anand2532/Nomiq/hardware/datasheets/README.md

# Datasheets & reference designs (links — don't commit PDFs)

| Part | Documents |
|---|---|
| ESP32-S3-WROOM-1 | Datasheet; ESP32-S3 Hardware Design Guidelines (Espressif) |
| SX1262 | Datasheet DS.SX1261-2; reference design 868 MHz (Semtech); AN1200.13 LoRa modem designer's guide |
| OV2640 | Datasheet; esp32-camera driver (github.com/espressif/esp32-camera) |
| ICS-43434 | Datasheet (TDK InvenSense) |
| MAX98357A | Datasheet (Analog Devices) |
| BQ25895 / BQ24074 | Datasheets (TI) |
| MAX17048 | Datasheet (Analog Devices) |
| TPS63001 | Datasheet (TI SLVS520) — DRC package, fixed 3.3 V |
| TPS22918, TLV755P | Datasheets (TI) |
| PE4259 | Datasheet (pSemi) |
| TG2016SMN | Datasheet (Epson) |
| TCA9535 | Datasheet (TI) |
