anand2532/Nomiq/docs/specs/ui-and-storage.md

# UI Flows & Local Storage

## 1. Controls

| Control | Short press | Long press |
|---|---|---|
| UP / DOWN | Move selection | Page scroll |
| SELECT | Confirm | Context menu |
| BACK | Back | Home |
| RECORD (side) | — | Hold-to-record (PTT) |
| CAMERA (side) | Open camera / capture | — |
| POWER | Screen on/off | 3 s: power off (ship mode) |

## 2. Screen map

```mermaid
stateDiagram-v2
  [*] --> Home
  Home --> Contacts: SELECT recipient
  Contacts --> Compose
  Compose --> VoiceRec: hold RECORD
  VoiceRec --> VoicePreview: release
  VoicePreview --> Sending: SEND
  Compose --> STT: "Voice to text"
  STT --> TextPreview: FINAL
  TextPreview --> Editor: EDIT
  TextPreview --> Sending: SEND
  Compose --> Camera: CAMERA
  Camera --> PhotoPreview: capture
  PhotoPreview --> Camera: RETAKE
  PhotoPreview --> Sending: SEND (shows size + ETA)
  Sending --> Home: delivered / backgrounded
  Home --> Inbox
  Inbox --> Viewer: open text / play voice / view photo
  Home --> Settings: radio, codec, photo quality, language, pairing
```

Implementation: `firmware/components/ui/ui_model.c` — a pure state machine (events in → view state + actions out) that the LVGL renderer draws. `test_ui_model.c` drives Modes 1–4 end to end (84 checks), incl. max recording length, low-confidence STT → send as voice, photo size/ETA, cancel, wake-on-receive, PTT from a dark screen and pairing.

Status bar on every screen: own ID, selected peer, RSSI/SNR bars, battery %, charging icon, active-transfer mini-progress.

**Long-transfer UX (REQ-UI-004):** before sending voice/photo show "≈ 1 min 15 s at current signal". During: % complete, ETA, retries, "Pause / Cancel / Run in background". Duty-cycle profile waits are shown as "Waiting for radio quota — 3 min".

## 3. Storage layout (microSD, FAT32)

```
/sd/nomiq/
  index.log            append-only log of 64-byte CRC-protected records (PUT / STATE)
  out/<peer>/<seq>.{txt,c2,jpg}
  in/<peer>/<seq>.{txt,c2,jpg}
  partial/<name>.bin   resumable receive state, written atomically (tmp + rename)
  pcm/tmp.pcm          raw recording scratch (deleted after encode/STT)
  contacts.json        paired peers: id, name, pubkey fingerprint
```

Keys are **not** on SD — they live in encrypted NVS.

**Storage-full (REQ-STO-004):** below 5 % free → warn; below 1 % → REJECT incoming bulk objects (reason STORAGE_FULL), still accept text; offer "delete oldest media".
Implementation: `firmware/components/storage/msg_store.c` (host-tested: `make test-storage`). A torn tail record after power loss is detected by CRC and truncated; the log is compacted when it exceeds 4× the live records. RAM index holds the newest 1024 messages.

**Persistence (REQ-STO-003):** every state change appended to `index.log` with fsync before radio action; on boot, PENDING/SENDING → PENDING and resume.
