anand2532/Nomiq/docs/specs/communication-protocol.md

# Nomiq Air Protocol — v1 (draft)

Reference implementation: `firmware/components/nomiq_proto/` (host-testable C). This document is normative; if code and doc disagree, open an issue.

## 1. Frame format

Max LoRa PHY payload 255 B. All multi-byte fields **little-endian**.

```
plaintext :  | header (20) | payload (len)                         |
encrypted :  | header (20) | ctr (4) | ciphertext (len) | MIC (8)  |   flags.b4 = 1
```

Header:

```
 0      1      2      3      4          8          12       14       16       18       20
+------+------+------+------+----------+----------+--------+--------+--------+--------+
| ver  | type | flags| len  | src u32  | dst u32  | msg_id | frag_ix| frag_n | crc16  |
+------+------+------+------+----------+----------+--------+--------+--------+--------+
```

| Field | Size | Description |
|---|---|---|
| `ver` | 1 | Protocol version = `1` |
| `type` | 1 | See §2 |
| `flags` | 1 | b0-1 priority (0 = control … 3 = photo), b2 ACK requested, b3 retransmission, b4 encrypted, b5-7 reserved |
| `len` | 1 | Plaintext payload length, 0–223 |
| `src` / `dst` | 4 / 4 | Device IDs. `0xFFFFFFFF` = broadcast (BEACON only) |
| `msg_id` | 2 | Per-sender message counter |
| `frag_ix` | 2 | Fragment index (0-based). For SACK = window base |
| `frag_n` | 2 | Total fragments of the object; 1 for single-frame messages |
| `crc16` | 2 | CRC-16/CCITT-FALSE over header bytes 0–17 **and every byte after the header** (payload, or ctr+ciphertext+MIC). Cheap corruption filter before crypto |
| `ctr` | 4 | Sender's 32-bit frame counter (encrypted frames) — nonce input and replay protection |
| `MIC` | 8 | AES-128-CCM tag |

Header = **20 B**, security trailer = **12 B**, max payload per fragment = 255 − 20 − 12 = **223 B**.

## 2. Message types

| Code | Name | Direction | Payload |
|---|---|---|---|
| 0x01 | TEXT | A→B | UTF-8 text ≤ 223 B (longer text is sent as an object) |
| 0x02 | OFFER | A→B | `obj_type u8` (text/voice/photo), `size u32`, `sha256[0:8]`, `codec/format u8`, `meta…` |
| 0x03 | ACCEPT | B→A | resume bitmap (fragments already held), optional data-channel |
| 0x04 | DATA | A→B | fragment bytes |
| 0x05 | SACK | B→A | 64-bit bitmap of window starting at `frag_ix`, `snr i8`, `rssi i8` |
| 0x06 | DONE | B→A | object verified & stored |
| 0x07 | CANCEL | either | reason u8 |
| 0x08 | REJECT | B→A | reason: storage full / too big / unknown sender |
| 0x09 | BEACON | broadcast | name, battery, capabilities (discovery) |
| 0x0A | PAIR | A↔B | X25519 public key + nonce (pairing) |
| 0x0B | ACK | B→A | ACK for TEXT / control frames |

## 3. Reliability

* **ACK/retry:** frames that expect a reply (TEXT, OFFER, last DATA of a window, probes) carry `ACK_REQ`. Timeout = 2ⁿ × (2·ToA + 300 ms) + jitter (n capped at 6), max **8** retries before `FAILED` (the message stays resumable).
* **Half-duplex listen hold:** after a frame with `ACK_REQ` the sender keeps the radio in RX for ≈ 2·ToA + 100 ms (or until the reply), so replies are never lost to our own transmissions.
* **Timeout recovery:** first timeout → probe (re-send the first unacknowledged fragment with `ACK_REQ`); further timeouts → re-OFFER. Re-OFFER also recovers a receiver that rebooted: it reloads the persisted partial by `(src, sha8)` and answers ACCEPT with its bitmap.
* **Windowed selective-repeat:** sender transmits up to 16 DATA frames (inside the 64-fragment SACK span), the last with `ACK_REQ`, then waits for SACK. Only missing fragments are resent. ACCEPT and SACK bitmaps are **authoritative** snapshots of the receiver (a receiver that discarded a corrupt object can un-acknowledge fragments).
* **Duplicate filter:** receiver keeps an LRU of the last 64 `(src, msg_id, frag_ix, type)` tuples; duplicates are re-ACKed but not re-processed.
* **Integrity:** per-frame CRC16 + MIC; per-object truncated SHA-256 in OFFER checked after reassembly. Mismatch → discard and request full resend.
* **Timeouts:** receiver drops an incomplete object after 30 min idle (configurable) but **keeps fragments on SD** so the sender can resume.
* **Resume:** both sides persist the bitmap on SD. A new OFFER with the same `(src, sha)` gets an ACCEPT carrying the bitmap of fragments already held.
* **Priority:** the scheduler (`nomiq_sched_pick`) grants the air one frame at a time: control > text > voice > photo. A text queued during a photo goes out after the current fragment (simulated: 0.6 s), not after the window.
* **Duty cycle:** `nomiq_duty_*` keeps a rolling 1-hour airtime ledger (60 × 1-min buckets) for the `IN865_SRD2021` profile; the radio layer checks `can_send` before every frame.

Reference implementation and tests: `nomiq_xfer.[ch]`, `test/test_nomiq_xfer.c` — discrete-event simulation with loss, half-duplex collisions, receiver/sender reboot, corruption, storage-full and a 60-run Monte-Carlo at 25 % loss.

## 4. Security

Implementation: `nomiq_crypto.[ch]` (+ `crypto_mbedtls.c` on ESP-IDF, `crypto_openssl.c` for host tests). Verified against RFC 3610 (CCM), RFC 5869 (HKDF) and RFC 7748 (X25519) vectors in `test/test_nomiq_crypto.c`.

* **Pairing (TOFU + confirmation):** devices exchange X25519 public keys in PAIR frames; both screens show a 6-digit code `HKDF(shared, "code" ‖ min(id) ‖ max(id)) mod 10⁶`; both users confirm. Keys stored in encrypted NVS.
* **Link key:** `K = HKDF-SHA256(salt = "nomiq v1", IKM = X25519 shared, info = "key " ‖ min(id) ‖ max(id))[0:16]`.
* **Cipher:** AES-128-CCM, 8-byte tag, AAD = header bytes 0–17 (so `dst`, `type`, `msg_id`, `frag_*`, `flags`, `len` are authenticated).
* **Nonce (13 B):** `src(4) ‖ ctr(4) ‖ type(1) ‖ msg_id(2) ‖ frag_ix(2)`. `ctr` is a per-sender frame counter that increments for **every** transmitted frame (including retransmissions), so a nonce is never reused under one key. The counter is persisted in NVS in blocks of 1024: on boot the device skips to the next block boundary.
* **Replay protection:** receiver keeps a 64-frame sliding window per peer (`nomiq_replay_accept`). The window is RAM-only; after a receiver reboot the first frame re-anchors it (accepted risk, documented).
* **Ordering on RX:** CRC → MIC/decrypt → replay window → protocol engine. Failures are counted in link statistics, never answered.
* Unpaired senders → REJECT (configurable "open mode" for demos). BEACON is plaintext.

## 5. State machines

Sender: `PENDING → OFFERED → SENDING(window) ↔ WAIT_SACK → WAIT_DONE → DELIVERED` (+ `FAILED`, `CANCELLED`, `PAUSED` for duty-cycle wait or user pause).
Receiver: `IDLE → RECEIVING → VERIFY → STORED`, `PARTIAL` (persisted, resumable).

## 6. Versioning

Unknown `ver` → drop silently. New optional fields go in payload TLVs; header layout is frozen for v1.
