anand2532/Nomiq/hardware/bom/bom-summary.md

# Nomiq A0 — cost summary (generated by hardware/design/gen_bom.py)

USD, list prices on 2026-10-24 where sourced, otherwise estimates — re-quote before ordering.

| Block | qty 1 (prototype) | qty 100 |
|---|---:|---:|
| Board components (125 placed parts, 71 lines) | 40.66 | 27.80 |
| PCB + assembly | 22.00 | 4.70 |
| Off-board (battery, speaker, camera, antenna, SD, enclosure, screws) | 20.80 | 13.80 |
| **Device total (without STT SoM)** | **83.46** | **46.30** |
| STT co-processor SoM (Phase 3, ADR-0002) | +15.00 | +12.00 |

## Largest line items (qty 1)

| Item | refs | ext. USD |
|---|---|---:|
| 2.4in 240x320 ILI9341 SPI module, 1x14 2.54 mm | J7 | 5.00 |
| TDK InvenSense ICS-43434 | U5 | 4.62 |
| Espressif ESP32-S3-WROOM-1-N16R8 | U1 | 4.60 |
| Semtech SX1262IMLTRT | U2 | 3.22 |
| Epson TG2016SMN 32.0000M-ECGNNM3 | Y1 | 2.79 |
| TI BQ24074RGTR | U8 | 2.53 |
| Molex 104031-0811 | J8 | 2.30 |
| Analog Devices MAX17048G+T10 | U9 | 2.11 |

## Supply risks

- **TI BQ24074RGTR** (U8): LCSC out of stock on 2026-10-24 - buy from TI/DigiKey or pre-order
- **Epson TG2016SMN 32.0000M-ECGNNM3** (Y1): 0 stock, 20 wk lead - order early or use a JLC-stocked 32 MHz 1.8 V TG2016 variant
