anand2532/Nomiq/hardware/bom/bom-costed.csv

designators | qty | mpn | value | footprint | lcsc | unit_usd_q1 | unit_usd_q100 | ext_usd_q1 | ext_usd_q100 | price_source | availability
J1 | 1 | GCT USB4105-GF-A | USB-C 16P | USB_C_Receptacle_GCT_USB4105-xx-A_16P_TopMnt_Horizontal |  | 0.800 | 0.550 | 0.80 | 0.55 | est.
R1 R2 | 2 |  | 5.1k | R_0402_1005Metric |  | 0.002 | 0.001 | 0.00 | 0.00 | est. (JLC basic part)
D1 | 1 | STMicro USBLC6-2SC6 | USBLC6-2SC6 | SOT-23-6 | C7519 | 0.120 | 0.070 | 0.12 | 0.07 | est.
D2 | 1 | Littelfuse SMF5.0A | SMF5.0A | D_SOD-123F |  | 0.100 | 0.050 | 0.10 | 0.05 | est.
C1 C6 C41 | 3 |  | 10uF/10V | C_0603_1608Metric |  | 0.010 | 0.005 | 0.03 | 0.01 | est. (JLC basic part)
U8 | 1 | TI BQ24074RGTR | BQ24074 | VQFN-16-1EP_3x3mm_P0.5mm_EP1.6x1.6mm | C54313 | 2.530 | 1.780 | 2.53 | 1.78 | LCSC | LCSC out of stock on 2026-10-24 - buy from TI/DigiKey or pre-order
R3 | 1 |  | 887R 1% | R_0402_1005Metric |  | 0.002 | 0.001 | 0.00 | 0.00 | est. (JLC basic part)
R4 | 1 |  | 1.13k 1% | R_0402_1005Metric |  | 0.002 | 0.001 | 0.00 | 0.00 | est. (JLC basic part)
R5 | 1 |  | 2.94k 1% | R_0402_1005Metric |  | 0.002 | 0.001 | 0.00 | 0.00 | est. (JLC basic part)
R6 | 1 |  | 37.4k 1% | R_0402_1005Metric |  | 0.002 | 0.001 | 0.00 | 0.00 | est. (JLC basic part)
R7 R8 R9 R13 R40 R41 R43 R50 R61 | 9 |  | 100k | R_0402_1005Metric |  | 0.002 | 0.001 | 0.02 | 0.01 | est. (JLC basic part)
C2 C5 C10 | 3 |  | 1uF/10V | C_0402_1005Metric |  | 0.003 | 0.002 | 0.01 | 0.00 | est. (JLC basic part)
C3 C4 | 2 |  | 4.7uF/10V | C_0603_1608Metric |  | 0.010 | 0.005 | 0.02 | 0.01 | est. (JLC basic part)
J2 | 1 | JST S3B-PH-SM4-TB | Battery JST-PH 3P (+, NTC, -) | JST_PH_S3B-PH-SM4-TB_1x03-1MP_P2.00mm_Horizontal |  | 0.200 | 0.120 | 0.20 | 0.12 | est.
U9 | 1 | Analog Devices MAX17048G+T10 | MAX17048 | TDFN-8-1EP_2x2mm_P0.5mm_EP0.8x1.2mm | C2682616 | 2.110 | 1.510 | 2.11 | 1.51 | LCSC | 25k in stock
U10 | 1 | TI TPS63001DRCR | TPS63001 | Texas_S-PVSON-N10 | C28060 | 1.620 | 1.010 | 1.62 | 1.01 | LCSC | 10k in stock
L1 | 1 | Taiyo Yuden NRS4018T2R2MDGJ | 2.2uH | L_Taiyo-Yuden_NR-40xx |  | 0.150 | 0.080 | 0.15 | 0.08 | est.
C7 C8 C21 | 3 |  | 22uF/6.3V | C_0805_2012Metric |  | 0.030 | 0.015 | 0.09 | 0.04 | est. (JLC basic part)
U14 | 1 | TI TPS22918DBVR | TPS22918 (STT rail) | SOT-23-6 |  | 0.350 | 0.200 | 0.35 | 0.20 | est.
C9 C50 | 2 |  | 1nF | C_0402_1005Metric |  | 0.003 | 0.002 | 0.01 | 0.00 | est. (JLC basic part)
C11 | 1 |  | 22uF/10V | C_0805_2012Metric |  | 0.030 | 0.015 | 0.03 | 0.01 | est. (JLC basic part)
U1 | 1 | Espressif ESP32-S3-WROOM-1-N16R8 | ESP32-S3-WROOM-1-N16R8 | ESP32-S3-WROOM-1 | C2913202 | 4.600 | 3.900 | 4.60 | 3.90 | est. (JLC extended part C2913202)
R20 R21 R30 R66 R62 R63 | 6 |  | 10k | R_0402_1005Metric |  | 0.002 | 0.001 | 0.01 | 0.01 | est. (JLC basic part)
C20 C51 C52 C53 | 4 |  | 1uF | C_0402_1005Metric |  | 0.003 | 0.002 | 0.01 | 0.01 | est. (JLC basic part)
C22 C23 C32 C35 C40 C42 C62 | 7 |  | 0.1uF | C_0402_1005Metric |  | 0.003 | 0.002 | 0.02 | 0.01 | est. (JLC basic part)
SW1 | 1 | C&K PTS810 SJM 250 SMTR LFS | RESET | SW_SPST_PTS810 |  | 0.180 | 0.110 | 0.18 | 0.11 | est.
SW2 | 1 | C&K PTS810 SJM 250 SMTR LFS | BOOT | SW_SPST_PTS810 |  | 0.180 | 0.110 | 0.18 | 0.11 | est.
R22 R23 | 2 |  | 0R | R_0402_1005Metric |  | 0.002 | 0.001 | 0.00 | 0.00 | est. (JLC basic part)
J3 | 1 | Tag-Connect TC2030-IDC-NL | TC2030-IDC-NL | Tag-Connect_TC2030-IDC-NL_2x03_P1.27mm_Vertical |  | 0.000 | 0.000 | 0.00 | 0.00 | footprint only (cable reused) | no part placed
U4 | 1 | TI TCA9535PWR | TCA9535 | TSSOP-24_4.4x7.8mm_P0.65mm | C130204 | 1.340 | 0.920 | 1.34 | 0.92 | LCSC | 7k in stock
R24 R25 | 2 |  | 2.2k | R_0402_1005Metric |  | 0.002 | 0.001 | 0.00 | 0.00 | est. (JLC basic part)
U2 | 1 | Semtech SX1262IMLTRT | SX1262 | QFN-24-1EP_4x4mm_P0.5mm_EP2.6x2.6mm | C191341 | 3.220 | 1.890 | 3.22 | 1.89 | LCSC | 1.5k-31k in stock
L2 | 1 | Murata LQM21FN150M70L | 15uH | L_0805_2012Metric |  | 0.060 | 0.030 | 0.06 | 0.03 | est.
C30 | 1 |  | 470nF | C_0402_1005Metric |  | 0.003 | 0.002 | 0.00 | 0.00 | est. (JLC basic part)
C31 | 1 |  | 47nF | C_0402_1005Metric |  | 0.003 | 0.002 | 0.00 | 0.00 | est. (JLC basic part)
C33 C60 C61 | 3 |  | 10uF/6.3V | C_0603_1608Metric |  | 0.010 | 0.005 | 0.03 | 0.01 | est. (JLC basic part)
Y1 | 1 | Epson TG2016SMN 32.0000M-ECGNNM3 | TCXO 32 MHz 1.8 V ±2 ppm | Crystal_SMD_2016-4Pin_2.0x1.6mm |  | 2.790 | 2.790 | 2.79 | 2.79 | Future Electronics (MOQ 250) | 0 stock, 20 wk lead - order early or use a JLC-stocked 32 MHz 1.8 V TG2016 variant
R31 | 1 |  | 220R | R_0402_1005Metric |  | 0.002 | 0.001 | 0.00 | 0.00 | est. (JLC basic part)
C34 | 1 |  | 10pF | C_0402_1005Metric |  | 0.003 | 0.002 | 0.00 | 0.00 | est. (JLC basic part)
U3 | 1 | pSemi PE4259-63 | PE4259 | SOT-363_SC-70-6 | C470892 | 0.950 | 0.600 | 0.95 | 0.60 | est. (LCSC C470892)
L3 | 1 | Murata LQW15AN47NJ00 | 47nH | L_0402_1005Metric |  | 0.050 | 0.020 | 0.05 | 0.02 | est.
C36 | 1 |  | 4.7pF | C_0402_1005Metric |  | 0.003 | 0.002 | 0.00 | 0.00 | est. (JLC basic part)
L4 L5 | 2 | Murata LQW15AN12NJ00 | 12nH | L_0402_1005Metric |  | 0.050 | 0.020 | 0.10 | 0.04 | est.
C37 | 1 |  | 6.8pF | C_0402_1005Metric |  | 0.003 | 0.002 | 0.00 | 0.00 | est. (JLC basic part)
C38 | 1 |  | 3.3pF | C_0402_1005Metric |  | 0.003 | 0.002 | 0.00 | 0.00 | est. (JLC basic part)
C39 C43 | 2 |  | 47pF | C_0402_1005Metric |  | 0.003 | 0.002 | 0.01 | 0.00 | est. (JLC basic part)
C44 C45 | 2 |  | 2.7pF | C_0402_1005Metric |  | 0.003 | 0.002 | 0.01 | 0.00 | est. (JLC basic part)
L6 L7 | 2 | Murata LQW15AN27NJ00 | 27nH | L_0402_1005Metric |  | 0.050 | 0.020 | 0.10 | 0.04 | est.
C47 | 1 |  | 100pF | C_0402_1005Metric |  | 0.003 | 0.002 | 0.00 | 0.00 | est. (JLC basic part)
J4 | 1 | Hirose U.FL-R-SMT-1(10) | u.FL | U.FL_Hirose_U.FL-R-SMT-1_Vertical |  | 0.250 | 0.150 | 0.25 | 0.15 | est.
D3 | 1 | Infineon ESD0P2RF-02LS | ESD RF (low C) | D_0201_0603Metric |  | 0.120 | 0.060 | 0.12 | 0.06 | est.
U5 | 1 | TDK InvenSense ICS-43434 | ICS-43434 | InvenSense_ICS-43434-6_3.5x2.65mm | C5656610 | 4.620 | 2.200 | 4.62 | 2.20 | LCSC qty 1; qty-100 est. | 1.6k in stock
U6 | 1 | Analog Devices MAX98357AETE+T | MAX98357A | TQFN-16-1EP_3x3mm_P0.5mm_EP1.23x1.23mm | C910544 | 1.330 | 0.950 | 1.33 | 0.95 | LCSC (qty-100 est.) | 22k in stock
J5 | 1 | JST SM02B-SRSS-TB | Speaker JST-SH 2P | JST_SH_SM02B-SRSS-TB_1x02-1MP_P1.00mm_Horizontal |  | 0.120 | 0.070 | 0.12 | 0.07 | est.
J6 | 1 | Hirose FH12-24S-0.5SH(55) | OV2640 24P FPC 0.5 mm | Hirose_FH12-24S-0.5SH_1x24-1MP_P0.50mm_Horizontal |  | 0.750 | 0.450 | 0.75 | 0.45 | est.
U12 | 1 | TI TLV75528PDBVR | TLV75528 (2.8 V) | SOT-23-5 |  | 0.150 | 0.080 | 0.15 | 0.08 | est.
U13 | 1 | TI TLV75512PDBVR | TLV75512 (1.2 V) | SOT-23-5 |  | 0.150 | 0.080 | 0.15 | 0.08 | est.
U15 | 1 | TI TPS22918DBVR | TPS22918 (cam 3V3) | SOT-23-6 |  | 0.350 | 0.200 | 0.35 | 0.20 | est.
R51 | 1 |  | 33R | R_0402_1005Metric |  | 0.002 | 0.001 | 0.00 | 0.00 | est. (JLC basic part)
J7 | 1 | 2.4in 240x320 ILI9341 SPI module, 1x14 2.54 mm | TFT 2.4in ILI9341 SPI module (14-pin) | TFT_2.4in_ILI9341_1x14 |  | 5.000 | 3.500 | 5.00 | 3.50 | est. (India retail ~INR 400-450) | touch variant OK, touch unused
Q2 | 1 | Nexperia 2N7002,215 | 2N7002 | SOT-23 | C8545 | 0.020 | 0.010 | 0.02 | 0.01 | est.
Q1 | 1 | AOS AO3401A | AO3401A | SOT-23 | C15127 | 0.030 | 0.020 | 0.03 | 0.02 | est.
R60 | 1 |  | 4.7R | R_0402_1005Metric |  | 0.002 | 0.001 | 0.00 | 0.00 | est. (JLC basic part)
J8 | 1 | Molex 104031-0811 | microSD push-push | microSD_HC_Molex_104031-0811 |  | 2.300 | 1.750 | 2.30 | 1.75 | element14 (AUD 3.55 -> USD) | 15k in stock
R64 R65 R70 R71 R72 R73 R74 R75 | 8 |  | 47k | R_0402_1005Metric |  | 0.002 | 0.001 | 0.02 | 0.01 | est. (JLC basic part)
SW3 SW4 SW5 SW6 | 4 | C&K PTS810 SJM 250 SMTR LFS | button (front) | SW_SPST_PTS810 |  | 0.180 | 0.110 | 0.72 | 0.44 | est.
D70 D71 D72 D73 D74 D75 | 6 | Nexperia PESD5V0S1BL | ESD | D_SOD-882 |  | 0.050 | 0.030 | 0.30 | 0.18 | est.
SW7 | 1 | Panasonic EVQ-P7A01P | button (left side) | SW_SPST_EVQP7A |  | 0.350 | 0.220 | 0.35 | 0.22 | est.
SW8 | 1 | Panasonic EVQ-P7A01P | button (right side) | SW_SPST_EVQP7A |  | 0.350 | 0.220 | 0.35 | 0.22 | est.
SW9 | 1 | Panasonic EVQ-P7A01P | POWER (ship-mode / wake) | SW_SPST_EVQP7A |  | 0.350 | 0.220 | 0.35 | 0.22 | est.
J9 | 1 | Samtec FTSH-105-01-L-DV | STT SoM interface 2x5 1.27 mm | PinHeader_2x05_P1.27mm_Vertical_SMD |  | 1.500 | 1.000 | 1.50 | 1.00 | est. | only if the STT SoM is fitted
(off-board) | 1 | 1S Li-ion pouch 3000 mAh (50x80x8 mm) with PCM + 10k NTC, JST-PH 3P |  |  |  | 6.00 | 4.00 | 6.00 | 4.00 | est.
(off-board) | 1 | Speaker 28 mm 8 ohm 1 W with JST-SH 2P lead |  |  |  | 0.90 | 0.50 | 0.90 | 0.50 | est.
(off-board) | 1 | OV2640 camera module, 24-pin 0.5 mm flex, 66-120 deg lens |  |  |  | 4.00 | 2.80 | 4.00 | 2.80 | est. (India retail)
(off-board) | 1 | 868 MHz antenna (SMA, 2-3 dBi) + u.FL-to-SMA bulkhead pigtail 100 mm |  |  |  | 3.00 | 1.80 | 3.00 | 1.80 | est.
(off-board) | 1 | microSD card 16 GB |  |  |  | 3.50 | 2.50 | 3.50 | 2.50 | est.
(off-board) | 1 | Enclosure FDM print (PETG/ASA, ~70 g) + 4 button caps |  |  |  | 3.00 | 2.00 | 3.00 | 2.00 | est. (material only)
(off-board) | 1 | M2.5x16 screws x4 + M2.5 heat-set inserts x4 |  |  |  | 0.40 | 0.20 | 0.40 | 0.20 | est.
(off-board) | 0 | STT co-processor SoM (ADR-0002, Phase 3) |  |  |  | 15.00 | 12.00 | 0.00 | 0.00 | est. - not in A0 build
(fab) | 1 | PCB 4-layer 1.6 mm ENIG 64.6x124.6 mm (per board, qty 5 / qty 100) |  |  |  | 8.00 | 2.20 | 8.00 | 2.20 | est. (JLCPCB)
(fab) | 1 | SMT assembly both sides (setup amortised over 5 / 100) + extended-part fees |  |  |  | 14.00 | 2.50 | 14.00 | 2.50 | est. (JLCPCB)
