anand2532/Nomiq/hardware/kicad/nomiq/nomiq.kicad_pcb

## KiCad design hardware/kicad/nomiq/nomiq.kicad_pcb (2026-10-24)

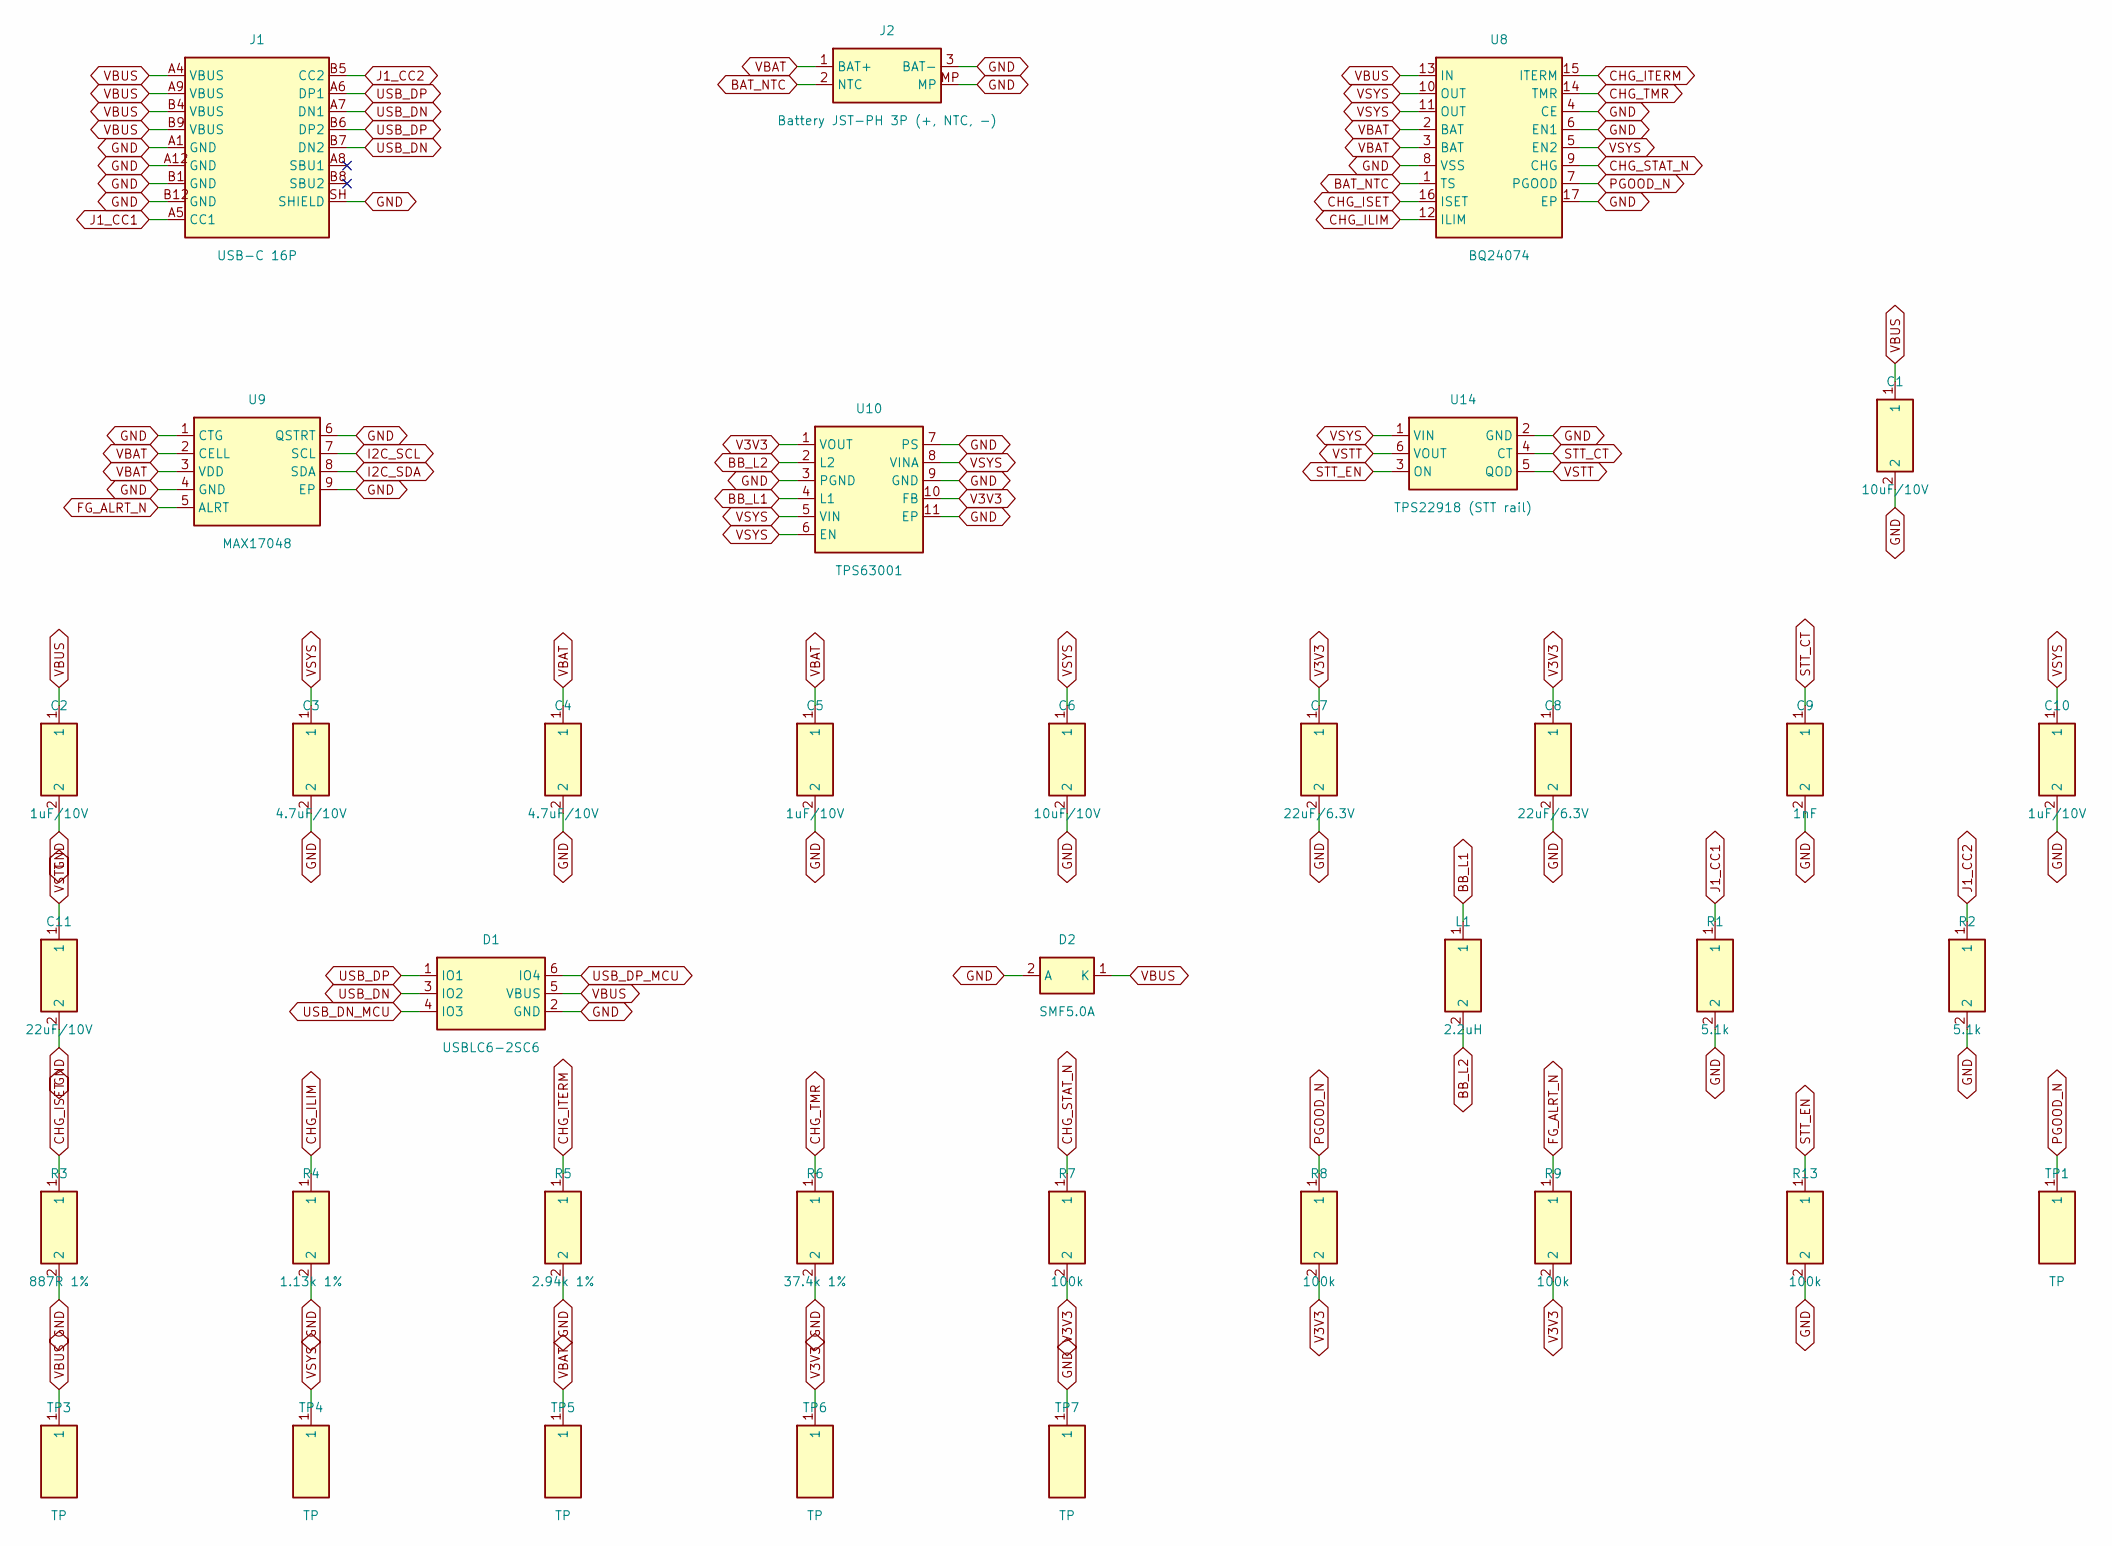
[picture p1: schematic 01_power.kicad_sch, Nomiq A0 — 01_power]

Parts:
C1, C6: 10uF/10V; C_0603_1608Metric
C2, C5, C10: 1uF/10V; C_0402_1005Metric
C3, C4: 4.7uF/10V; C_0603_1608Metric
C7, C8: 22uF/6.3V; C_0805_2012Metric
C9: 1nF; C_0402_1005Metric
C11: 22uF/10V; C_0805_2012Metric
D1: USBLC6-2SC6; SOT-23-6; MPN STMicro USBLC6-2SC6
D2: SMF5.0A; D_SOD-123F; MPN Littelfuse SMF5.0A
J1: USB-C 16P; USB_C_Receptacle_GCT_USB4105-xx-A_16P_TopMnt_Horizontal; MPN GCT USB4105-GF-A
J2: Battery JST-PH 3P (+, NTC, -); JST_PH_S3B-PH-SM4-TB_1x03-1MP_P2.00mm_Horizontal; MPN JST S3B-PH-SM4-TB
L1: 2.2uH; L_Taiyo-Yuden_NR-40xx; MPN Taiyo Yuden NRS4018T2R2MDGJ
R1, R2: 5.1k; R_0402_1005Metric
R3: 887R 1%; R_0402_1005Metric
R4: 1.13k 1%; R_0402_1005Metric
R5: 2.94k 1%; R_0402_1005Metric
R6: 37.4k 1%; R_0402_1005Metric
R7, R8, R9, R13: 100k; R_0402_1005Metric
TP1, TP3, TP4, TP5, TP6, TP7: TP; TestPoint_Pad_D1.0mm
U8: BQ24074; VQFN-16-1EP_3x3mm_P0.5mm_EP1.6x1.6mm; MPN TI BQ24074RGTR
U9: MAX17048; TDFN-8-1EP_2x2mm_P0.5mm_EP0.8x1.2mm; MPN Analog Devices MAX17048G+T10
U10: TPS63001; Texas_S-PVSON-N10; MPN TI TPS63001DRCR
U14: TPS22918 (STT rail); SOT-23-6; MPN TI TPS22918DBVR

Connections:
BAT_NTC: J2.2 (NTC), U8.1 (TS)
BB_L1: L1.1, U10.4 (L1)
BB_L2: L1.2, U10.2 (L2)
CHG_ILIM: R4.1, U8.12 (ILIM)
CHG_ISET: R3.1, U8.16 (ISET)
CHG_ITERM: R5.1, U8.15 (ITERM)
CHG_STAT_N: R7.1, U8.9 (CHG); also elsewhere on the board
CHG_TMR: R6.1, U8.14 (TMR)
FG_ALRT_N: R9.1, U9.5 (ALRT); also elsewhere on the board
GND: C1.2, C2.2, C3.2, C4.2, C5.2, C6.2, C7.2, C8.2, C9.2, C10.2, C11.2, D1.2 (GND), D2.2 (A), J1.A1 (GND), J1.A12 (GND), J1.B1 (GND), J1.B12 (GND), J1.SH (SHIELD), J2.3 (BAT-), J2.MP, R1.2, R2.2, R3.2, R4.2, R5.2, R6.2, R13.2, TP7.1, U8.4 (CE), U8.6 (EN1), U8.8 (VSS), U8.17 (EP), U9.1 (CTG), U9.4 (GND), U9.6 (QSTRT), U9.9 (EP), U10.3 (PGND), U10.7 (PS), U10.9 (GND), U10.11 (EP), U14.2 (GND); also elsewhere on the board
I2C_SCL: U9.7 (SCL); also elsewhere on the board
I2C_SDA: U9.8 (SDA); also elsewhere on the board
J1_CC1: J1.A5 (CC1), R1.1
J1_CC2: J1.B5 (CC2), R2.1
PGOOD_N: R8.1, TP1.1, U8.7 (PGOOD)
STT_CT: C9.1, U14.4 (CT)
STT_EN: R13.1, U14.3 (ON); also elsewhere on the board
USB_DN: D1.3 (IO2), J1.A7 (DN1), J1.B7 (DN2)
USB_DN_MCU: D1.4 (IO3); also elsewhere on the board
USB_DP: D1.1 (IO1), J1.A6 (DP1), J1.B6 (DP2)
USB_DP_MCU: D1.6 (IO4); also elsewhere on the board
V3V3: C7.1, C8.1, R7.2, R8.2, R9.2, TP6.1, U10.1 (VOUT), U10.10 (FB); also elsewhere on the board
VBAT: C4.1, C5.1, J2.1 (BAT+), TP5.1, U8.2 (BAT), U8.3 (BAT), U9.2 (CELL), U9.3 (VDD)
VBUS: C1.1, C2.1, D1.5 (VBUS), D2.1 (K), J1.A4 (VBUS), J1.A9 (VBUS), J1.B4 (VBUS), J1.B9 (VBUS), TP3.1, U8.13 (IN)
VSTT: C11.1, U14.5 (QOD), U14.6 (VOUT); also elsewhere on the board
VSYS: C3.1, C6.1, C10.1, TP4.1, U8.5 (EN2), U8.10 (OUT), U8.11 (OUT), U10.5 (VIN), U10.6 (EN), U10.8 (VINA), U14.1 (VIN); also elsewhere on the board

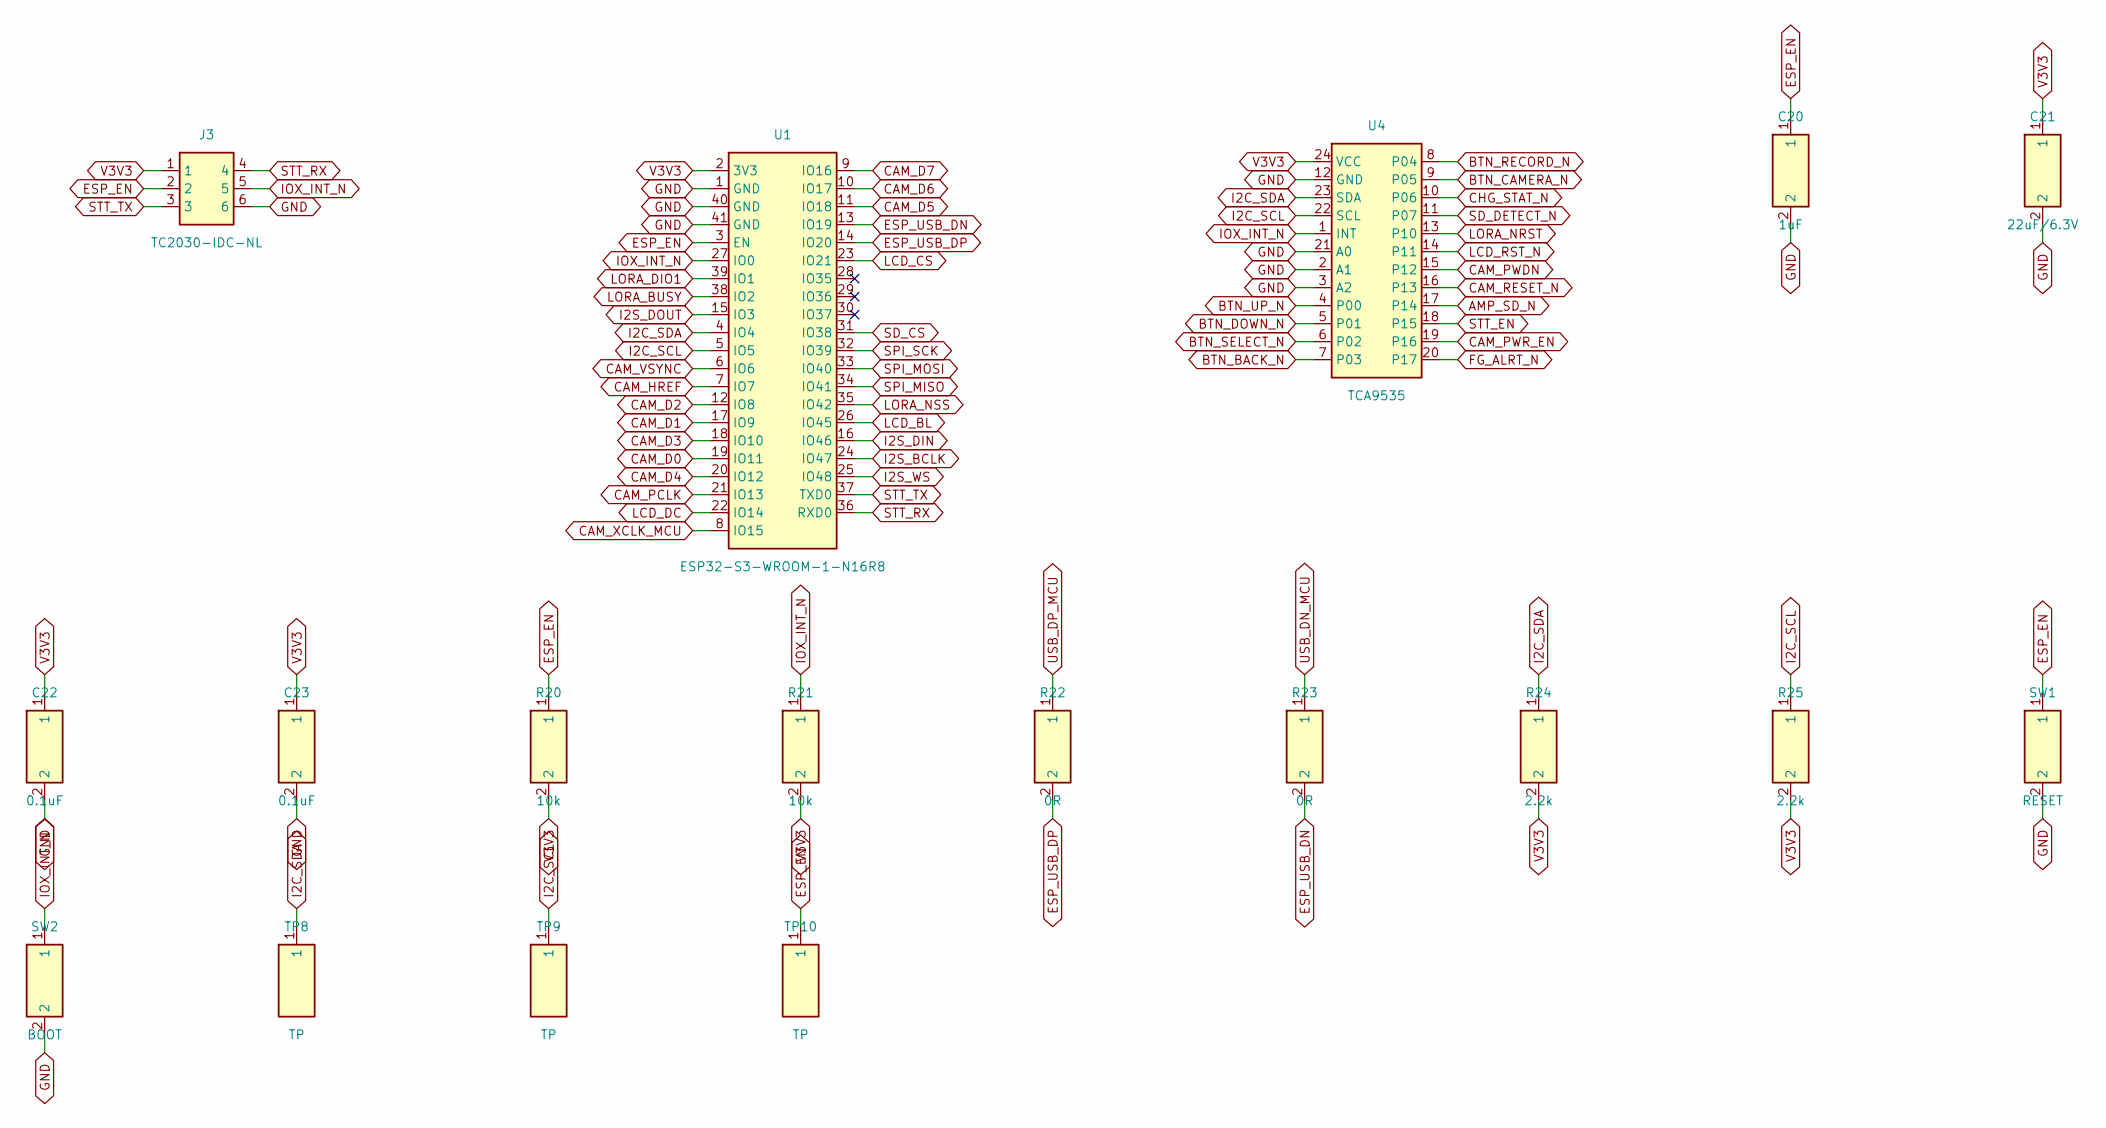
[picture p2: schematic 02_mcu.kicad_sch, Nomiq A0 — 02_mcu]

Parts:
C20: 1uF; C_0402_1005Metric
C21: 22uF/6.3V; C_0805_2012Metric
C22, C23: 0.1uF; C_0402_1005Metric
J3: TC2030-IDC-NL; Tag-Connect_TC2030-IDC-NL_2x03_P1.27mm_Vertical; MPN Tag-Connect TC2030-IDC-NL
R20, R21: 10k; R_0402_1005Metric
R22, R23: 0R; R_0402_1005Metric
R24, R25: 2.2k; R_0402_1005Metric
SW1: RESET; SW_SPST_PTS810; MPN C&K PTS810 SJM 250 SMTR LFS
SW2: BOOT; SW_SPST_PTS810; MPN C&K PTS810 SJM 250 SMTR LFS
TP8, TP9, TP10: TP; TestPoint_Pad_D1.0mm
U1: ESP32-S3-WROOM-1-N16R8; ESP32-S3-WROOM-1; MPN Espressif ESP32-S3-WROOM-1-N16R8
U4: TCA9535; TSSOP-24_4.4x7.8mm_P0.65mm; MPN TI TCA9535PWR

Connections:
AMP_SD_N: U4.17 (P14); also elsewhere on the board
BTN_BACK_N: U4.7 (P03); also elsewhere on the board
BTN_CAMERA_N: U4.9 (P05); also elsewhere on the board
BTN_DOWN_N: U4.5 (P01); also elsewhere on the board
BTN_RECORD_N: U4.8 (P04); also elsewhere on the board
BTN_SELECT_N: U4.6 (P02); also elsewhere on the board
BTN_UP_N: U4.4 (P00); also elsewhere on the board
CAM_D0: U1.19 (IO11); also elsewhere on the board
CAM_D1: U1.17 (IO9); also elsewhere on the board
CAM_D2: U1.12 (IO8); also elsewhere on the board
CAM_D3: U1.18 (IO10); also elsewhere on the board
CAM_D4: U1.20 (IO12); also elsewhere on the board
CAM_D5: U1.11 (IO18); also elsewhere on the board
CAM_D6: U1.10 (IO17); also elsewhere on the board
CAM_D7: U1.9 (IO16); also elsewhere on the board
CAM_HREF: U1.7 (IO7); also elsewhere on the board
CAM_PCLK: U1.21 (IO13); also elsewhere on the board
CAM_PWDN: U4.15 (P12); also elsewhere on the board
CAM_PWR_EN: U4.19 (P16); also elsewhere on the board
CAM_RESET_N: U4.16 (P13); also elsewhere on the board
CAM_VSYNC: U1.6 (IO6); also elsewhere on the board
CAM_XCLK_MCU: U1.8 (IO15); also elsewhere on the board
CHG_STAT_N: U4.10 (P06); also elsewhere on the board
ESP_EN: C20.1, J3.2, R20.1, SW1.1, TP10.1, U1.3 (EN); also elsewhere on the board
ESP_USB_DN: R23.2, U1.13 (IO19)
ESP_USB_DP: R22.2, U1.14 (IO20)
FG_ALRT_N: U4.20 (P17); also elsewhere on the board
GND: C20.2, C21.2, C22.2, C23.2, J3.6, SW1.2, SW2.2, U1.1 (GND), U1.40 (GND), U1.41 (GND), U4.2 (A1), U4.3 (A2), U4.12 (GND), U4.21 (A0); also elsewhere on the board
I2C_SCL: R25.1, TP9.1, U1.5 (IO5), U4.22 (SCL); also elsewhere on the board
I2C_SDA: R24.1, TP8.1, U1.4 (IO4), U4.23 (SDA); also elsewhere on the board
I2S_BCLK: U1.24 (IO47); also elsewhere on the board
I2S_DIN: U1.16 (IO46); also elsewhere on the board
I2S_DOUT: U1.15 (IO3); also elsewhere on the board
I2S_WS: U1.25 (IO48); also elsewhere on the board
IOX_INT_N: J3.5, R21.1, SW2.1, U1.27 (IO0), U4.1 (INT)
LCD_BL: U1.26 (IO45); also elsewhere on the board
LCD_CS: U1.23 (IO21); also elsewhere on the board
LCD_DC: U1.22 (IO14); also elsewhere on the board
LCD_RST_N: U4.14 (P11); also elsewhere on the board
LORA_BUSY: U1.38 (IO2); also elsewhere on the board
LORA_DIO1: U1.39 (IO1); also elsewhere on the board
LORA_NRST: U4.13 (P10); also elsewhere on the board
LORA_NSS: U1.35 (IO42); also elsewhere on the board
SD_CS: U1.31 (IO38); also elsewhere on the board
SD_DETECT_N: U4.11 (P07); also elsewhere on the board
SPI_MISO: U1.34 (IO41); also elsewhere on the board
SPI_MOSI: U1.33 (IO40); also elsewhere on the board
SPI_SCK: U1.32 (IO39); also elsewhere on the board
STT_EN: U4.18 (P15); also elsewhere on the board
STT_RX: J3.4, U1.36 (RXD0); also elsewhere on the board
STT_TX: J3.3, U1.37 (TXD0); also elsewhere on the board
USB_DN_MCU: R23.1; also elsewhere on the board
USB_DP_MCU: R22.1; also elsewhere on the board
V3V3: C21.1, C22.1, C23.1, J3.1, R20.2, R21.2, R24.2, R25.2, U1.2 (3V3), U4.24 (VCC); also elsewhere on the board

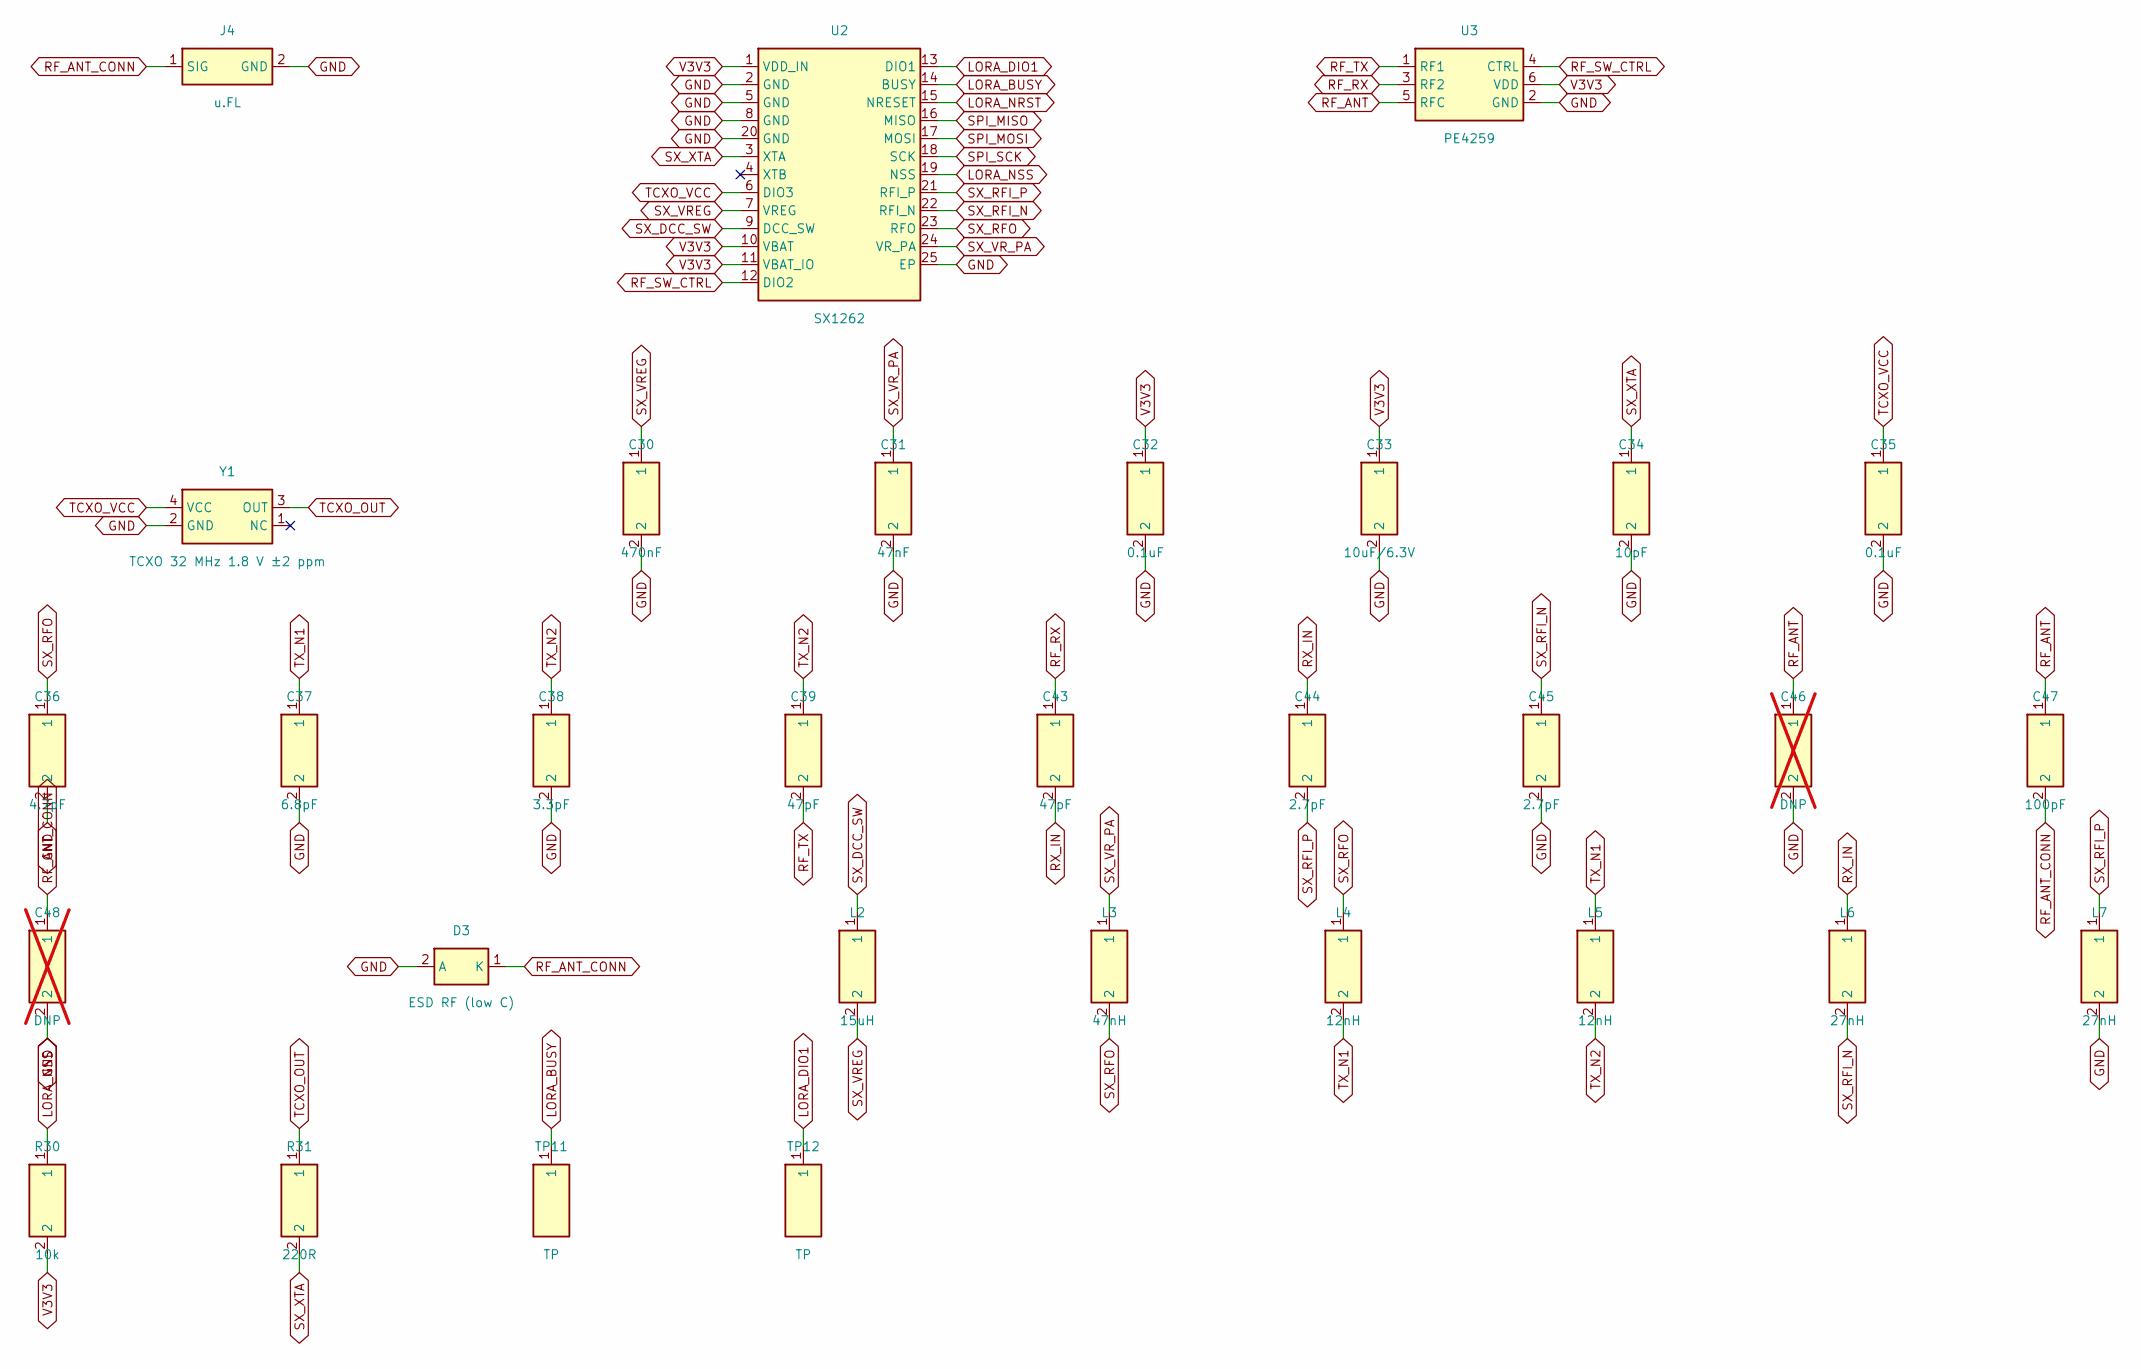
[picture p3: schematic 03_radio.kicad_sch, Nomiq A0 — 03_radio]

Parts:
C30: 470nF; C_0402_1005Metric
C31: 47nF; C_0402_1005Metric
C32, C35: 0.1uF; C_0402_1005Metric
C33: 10uF/6.3V; C_0603_1608Metric
C34: 10pF; C_0402_1005Metric
C36: 4.7pF; C_0402_1005Metric
C37: 6.8pF; C_0402_1005Metric
C38: 3.3pF; C_0402_1005Metric
C39, C43: 47pF; C_0402_1005Metric
C44, C45: 2.7pF; C_0402_1005Metric
C46, C48: DNP; C_0402_1005Metric; not fitted
C47: 100pF; C_0402_1005Metric
D3: ESD RF (low C); D_0201_0603Metric; MPN Infineon ESD0P2RF-02LS
J4: u.FL; U.FL_Hirose_U.FL-R-SMT-1_Vertical; MPN Hirose U.FL-R-SMT-1(10)
L2: 15uH; L_0805_2012Metric; MPN Murata LQM21FN150M70L
L3: 47nH; L_0402_1005Metric; MPN Murata LQW15AN47NJ00
L4, L5: 12nH; L_0402_1005Metric; MPN Murata LQW15AN12NJ00
L6, L7: 27nH; L_0402_1005Metric; MPN Murata LQW15AN27NJ00
R30: 10k; R_0402_1005Metric
R31: 220R; R_0402_1005Metric
TP11, TP12: TP; TestPoint_Pad_D1.0mm
U2: SX1262; QFN-24-1EP_4x4mm_P0.5mm_EP2.6x2.6mm; MPN Semtech SX1262IMLTRT
U3: PE4259; SOT-363_SC-70-6; MPN pSemi PE4259-63
Y1: TCXO 32 MHz 1.8 V ±2 ppm; Crystal_SMD_2016-4Pin_2.0x1.6mm; MPN Epson TG2016SMN 32.0000M-ECGNNM3

Connections:
GND: C30.2, C31.2, C32.2, C33.2, C34.2, C35.2, C36.2, C37.2, C38.2, C45.2, C46.2, C48.2, D3.2 (A), J4.2 (GND), L7.2, U2.2 (GND), U2.5 (GND), U2.8 (GND), U2.20 (GND), U2.25 (EP), U3.2 (GND), Y1.2 (GND); also elsewhere on the board
LORA_BUSY: TP11.1, U2.14 (BUSY); also elsewhere on the board
LORA_DIO1: TP12.1, U2.13 (DIO1); also elsewhere on the board
LORA_NRST: U2.15 (NRESET); also elsewhere on the board
LORA_NSS: R30.1, U2.19 (NSS); also elsewhere on the board
RF_ANT: C46.1, C47.1, U3.5 (RFC)
RF_ANT_CONN: C47.2, C48.1, D3.1 (K), J4.1 (SIG)
RF_RX: C43.1, U3.3 (RF2)
RF_SW_CTRL: U2.12 (DIO2), U3.4 (CTRL)
RF_TX: C39.2, U3.1 (RF1)
RX_IN: C43.2, C44.1, L6.1
SPI_MISO: U2.16 (MISO); also elsewhere on the board
SPI_MOSI: U2.17 (MOSI); also elsewhere on the board
SPI_SCK: U2.18 (SCK); also elsewhere on the board
SX_DCC_SW: L2.1, U2.9 (DCC_SW)
SX_RFI_N: C45.1, L6.2, U2.22 (RFI_N)
SX_RFI_P: C44.2, L7.1, U2.21 (RFI_P)
SX_RFO: C36.1, L3.2, L4.1, U2.23 (RFO)
SX_VREG: C30.1, L2.2, U2.7 (VREG)
SX_VR_PA: C31.1, L3.1, U2.24 (VR_PA)
SX_XTA: C34.1, R31.2, U2.3 (XTA)
TCXO_OUT: R31.1, Y1.3 (OUT)
TCXO_VCC: C35.1, U2.6 (DIO3), Y1.4 (VCC)
TX_N1: C37.1, L4.2, L5.1
TX_N2: C38.1, C39.1, L5.2
V3V3: C32.1, C33.1, R30.2, U2.1 (VDD_IN), U2.10 (VBAT), U2.11 (VBAT_IO), U3.6 (VDD); also elsewhere on the board

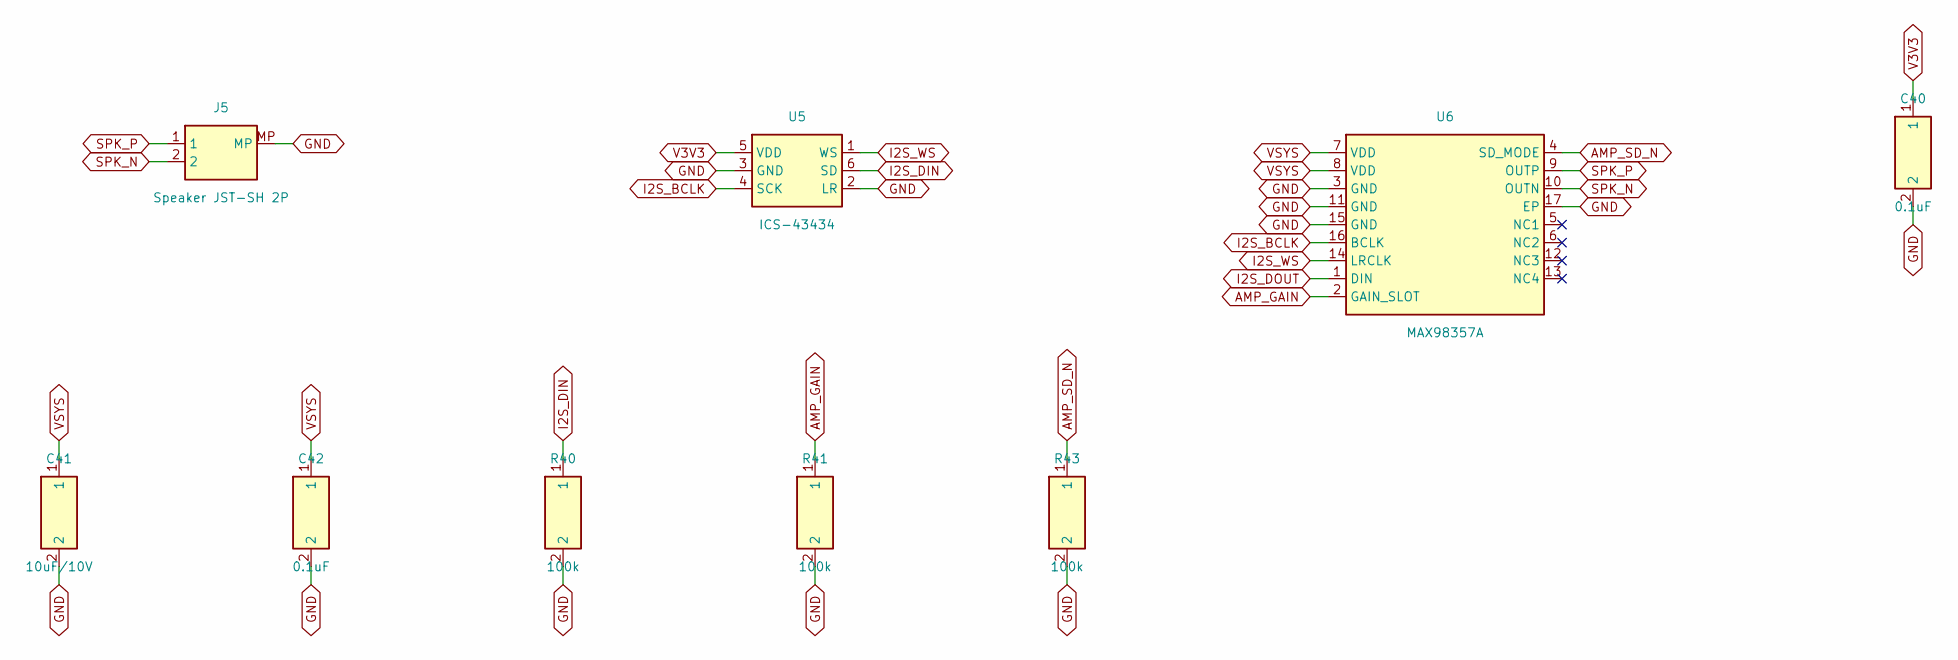
[picture p4: schematic 04_audio.kicad_sch, Nomiq A0 — 04_audio]

Parts:
C40, C42: 0.1uF; C_0402_1005Metric
C41: 10uF/10V; C_0603_1608Metric
J5: Speaker JST-SH 2P; JST_SH_SM02B-SRSS-TB_1x02-1MP_P1.00mm_Horizontal; MPN JST SM02B-SRSS-TB
R40, R41, R43: 100k; R_0402_1005Metric
U5: ICS-43434; InvenSense_ICS-43434-6_3.5x2.65mm; MPN TDK InvenSense ICS-43434
U6: MAX98357A; TQFN-16-1EP_3x3mm_P0.5mm_EP1.23x1.23mm; MPN Analog Devices MAX98357AETE+T

Connections:
AMP_GAIN: R41.1, U6.2 (GAIN_SLOT)
AMP_SD_N: R43.1, U6.4 (SD_MODE); also elsewhere on the board
GND: C40.2, C41.2, C42.2, J5.MP, R40.2, R41.2, R43.2, U5.2 (LR), U5.3 (GND), U6.3 (GND), U6.11 (GND), U6.15 (GND), U6.17 (EP); also elsewhere on the board
I2S_BCLK: U5.4 (SCK), U6.16 (BCLK); also elsewhere on the board
I2S_DIN: R40.1, U5.6 (SD); also elsewhere on the board
I2S_DOUT: U6.1 (DIN); also elsewhere on the board
I2S_WS: U5.1 (WS), U6.14 (LRCLK); also elsewhere on the board
SPK_N: J5.2, U6.10 (OUTN)
SPK_P: J5.1, U6.9 (OUTP)
V3V3: C40.1, U5.5 (VDD); also elsewhere on the board
VSYS: C41.1, C42.1, U6.7 (VDD), U6.8 (VDD); also elsewhere on the board

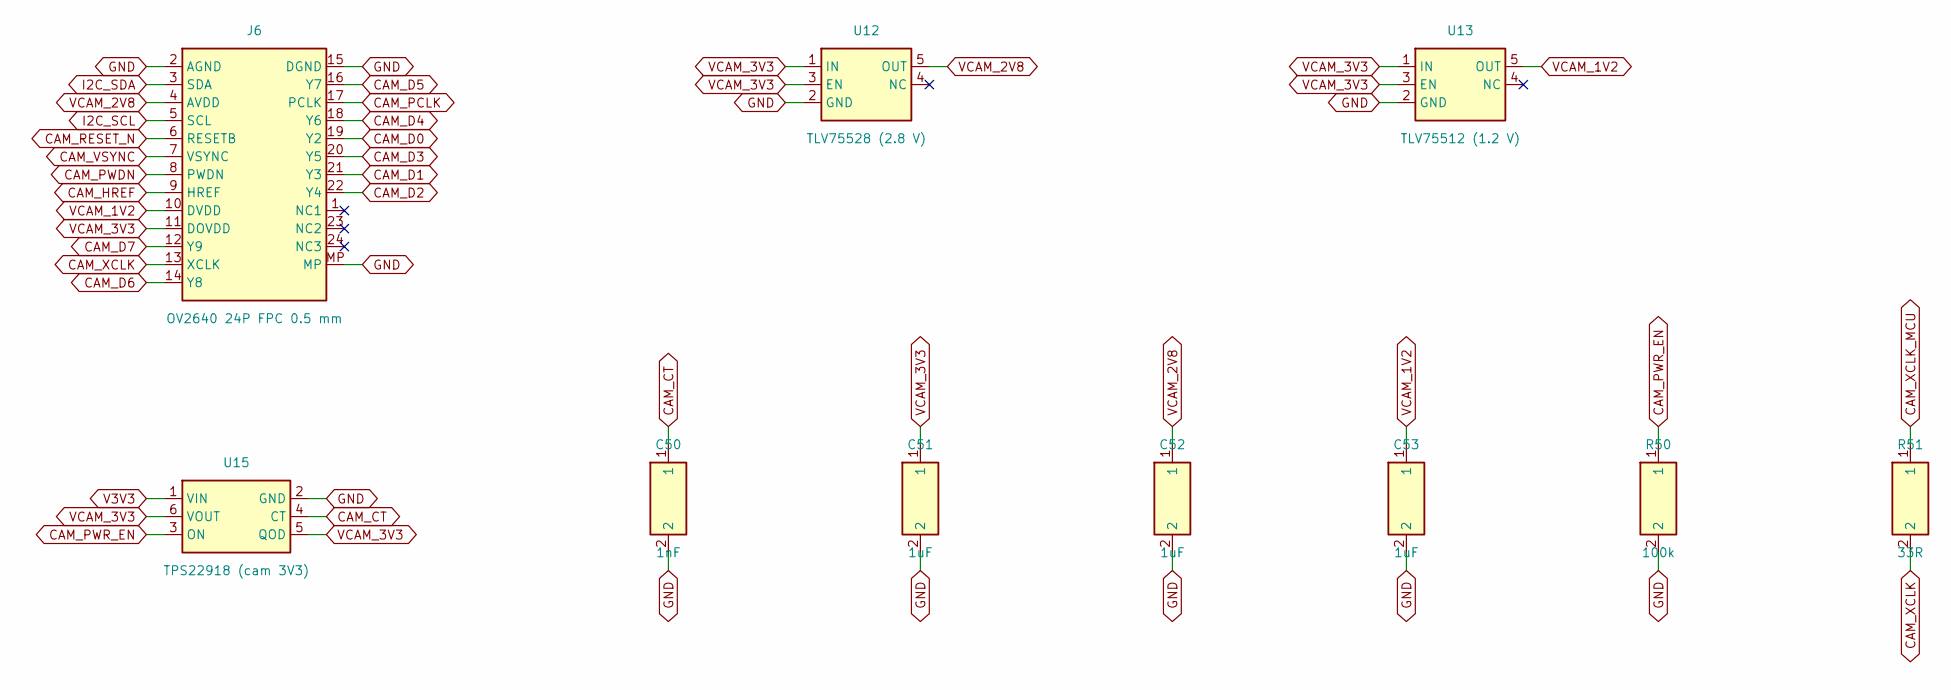
[picture p5: schematic 05_camera.kicad_sch, Nomiq A0 — 05_camera]

Parts:
C50: 1nF; C_0402_1005Metric
C51, C52, C53: 1uF; C_0402_1005Metric
J6: OV2640 24P FPC 0.5 mm; Hirose_FH12-24S-0.5SH_1x24-1MP_P0.50mm_Horizontal; MPN Hirose FH12-24S-0.5SH(55)
R50: 100k; R_0402_1005Metric
R51: 33R; R_0402_1005Metric
U12: TLV75528 (2.8 V); SOT-23-5; MPN TI TLV75528PDBVR
U13: TLV75512 (1.2 V); SOT-23-5; MPN TI TLV75512PDBVR
U15: TPS22918 (cam 3V3); SOT-23-6; MPN TI TPS22918DBVR

Connections:
CAM_CT: C50.1, U15.4 (CT)
CAM_D0: J6.19 (Y2); also elsewhere on the board
CAM_D1: J6.21 (Y3); also elsewhere on the board
CAM_D2: J6.22 (Y4); also elsewhere on the board
CAM_D3: J6.20 (Y5); also elsewhere on the board
CAM_D4: J6.18 (Y6); also elsewhere on the board
CAM_D5: J6.16 (Y7); also elsewhere on the board
CAM_D6: J6.14 (Y8); also elsewhere on the board
CAM_D7: J6.12 (Y9); also elsewhere on the board
CAM_HREF: J6.9 (HREF); also elsewhere on the board
CAM_PCLK: J6.17 (PCLK); also elsewhere on the board
CAM_PWDN: J6.8 (PWDN); also elsewhere on the board
CAM_PWR_EN: R50.1, U15.3 (ON); also elsewhere on the board
CAM_RESET_N: J6.6 (RESETB); also elsewhere on the board
CAM_VSYNC: J6.7 (VSYNC); also elsewhere on the board
CAM_XCLK: J6.13 (XCLK), R51.2
CAM_XCLK_MCU: R51.1; also elsewhere on the board
GND: C50.2, C51.2, C52.2, C53.2, J6.2 (AGND), J6.15 (DGND), J6.MP, R50.2, U12.2 (GND), U13.2 (GND), U15.2 (GND); also elsewhere on the board
I2C_SCL: J6.5 (SCL); also elsewhere on the board
I2C_SDA: J6.3 (SDA); also elsewhere on the board
V3V3: U15.1 (VIN); also elsewhere on the board
VCAM_1V2: C53.1, J6.10 (DVDD), U13.5 (OUT)
VCAM_2V8: C52.1, J6.4 (AVDD), U12.5 (OUT)
VCAM_3V3: C51.1, J6.11 (DOVDD), U12.1 (IN), U12.3 (EN), U13.1 (IN), U13.3 (EN), U15.5 (QOD), U15.6 (VOUT)

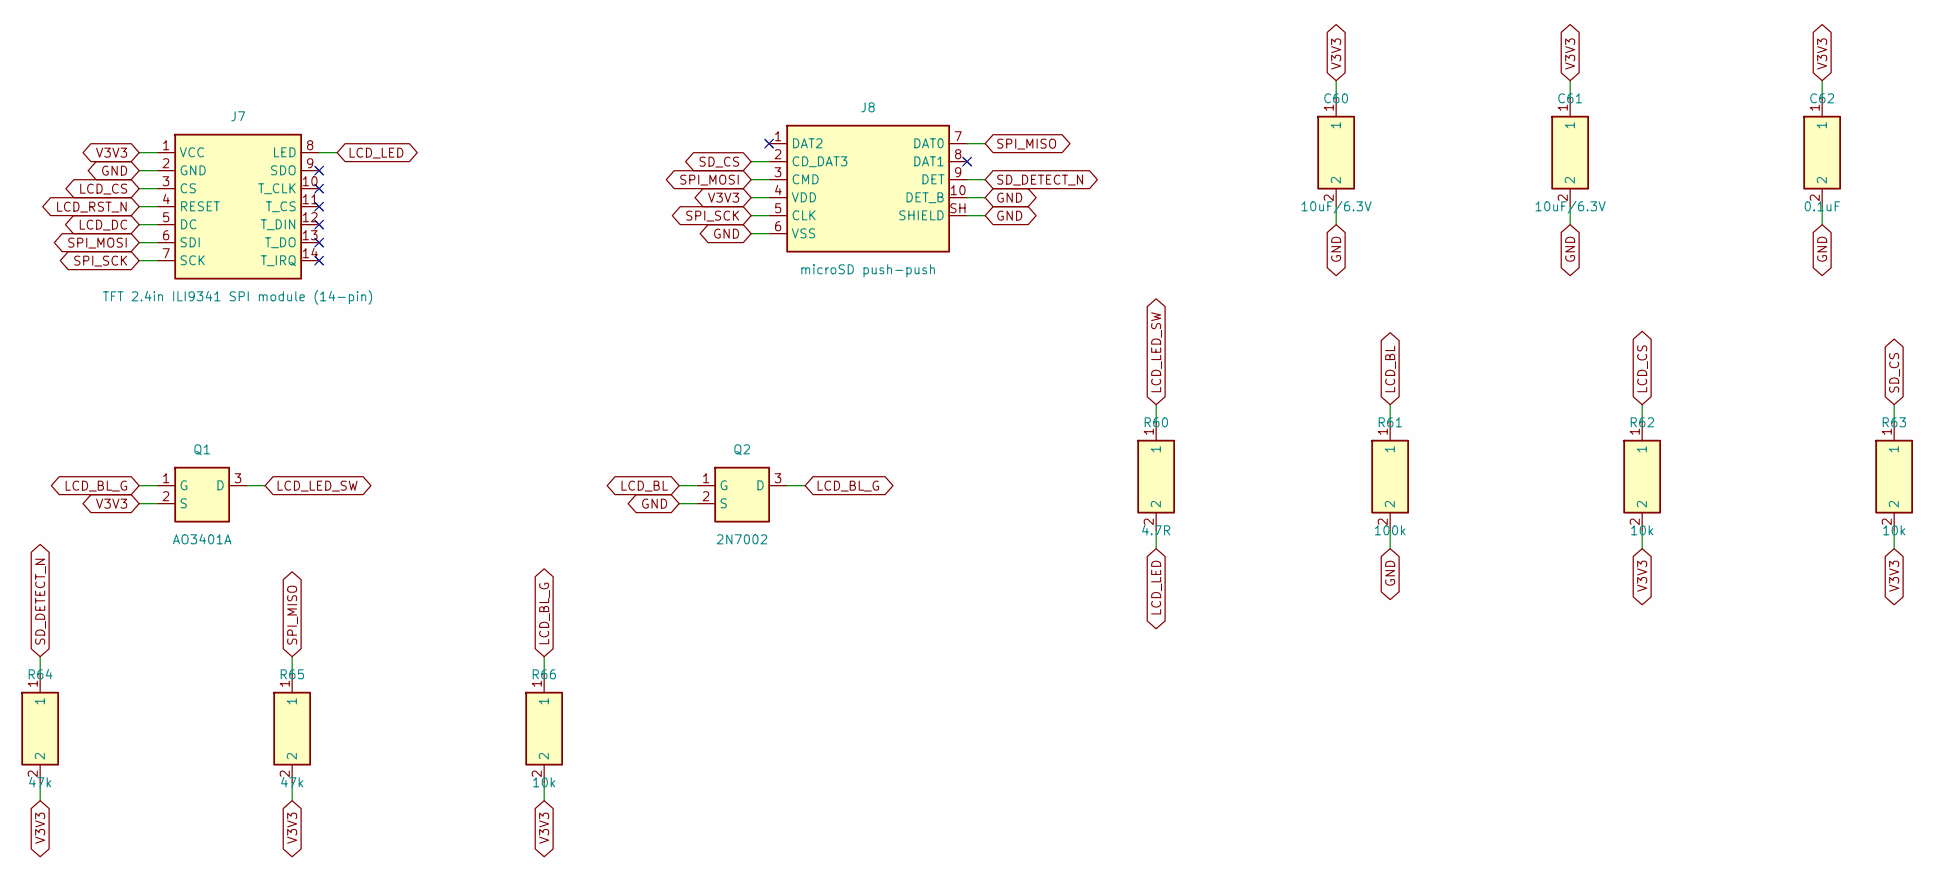
[picture p6: schematic 06_display_storage.kicad_sch, Nomiq A0 — 06_display_storage]

Parts:
C60, C61: 10uF/6.3V; C_0603_1608Metric
C62: 0.1uF; C_0402_1005Metric
J7: TFT 2.4in ILI9341 SPI module (14-pin); TFT_2.4in_ILI9341_1x14; MPN 2.4in 240x320 ILI9341 SPI module, 1x14 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
J8: microSD push-push; microSD_HC_Molex_104031-0811; MPN Molex 104031-0811
Q1: AO3401A; SOT-23; MPN AOS AO3401A
Q2: 2N7002; SOT-23; MPN Nexperia 2N7002,215
R60: 4.7R; R_0402_1005Metric
R61: 100k; R_0402_1005Metric
R62, R63, R66: 10k; R_0402_1005Metric
R64, R65: 47k; R_0402_1005Metric

Connections:
GND: C60.2, C61.2, C62.2, J7.2 (GND), J8.6 (VSS), J8.10 (DET_B), J8.SH (SHIELD), Q2.2 (S), R61.2; also elsewhere on the board
LCD_BL: Q2.1 (G), R61.1; also elsewhere on the board
LCD_BL_G: Q1.1 (G), Q2.3 (D), R66.1
LCD_CS: J7.3 (CS), R62.1; also elsewhere on the board
LCD_DC: J7.5 (DC); also elsewhere on the board
LCD_LED: J7.8 (LED), R60.2
LCD_LED_SW: Q1.3 (D), R60.1
LCD_RST_N: J7.4 (RESET); also elsewhere on the board
SD_CS: J8.2 (CD_DAT3), R63.1; also elsewhere on the board
SD_DETECT_N: J8.9 (DET), R64.1; also elsewhere on the board
SPI_MISO: J8.7 (DAT0), R65.1; also elsewhere on the board
SPI_MOSI: J7.6 (SDI), J8.3 (CMD); also elsewhere on the board
SPI_SCK: J7.7 (SCK), J8.5 (CLK); also elsewhere on the board
V3V3: C60.1, C61.1, C62.1, J7.1 (VCC), J8.4 (VDD), Q1.2 (S), R62.2, R63.2, R64.2, R65.2, R66.2; also elsewhere on the board

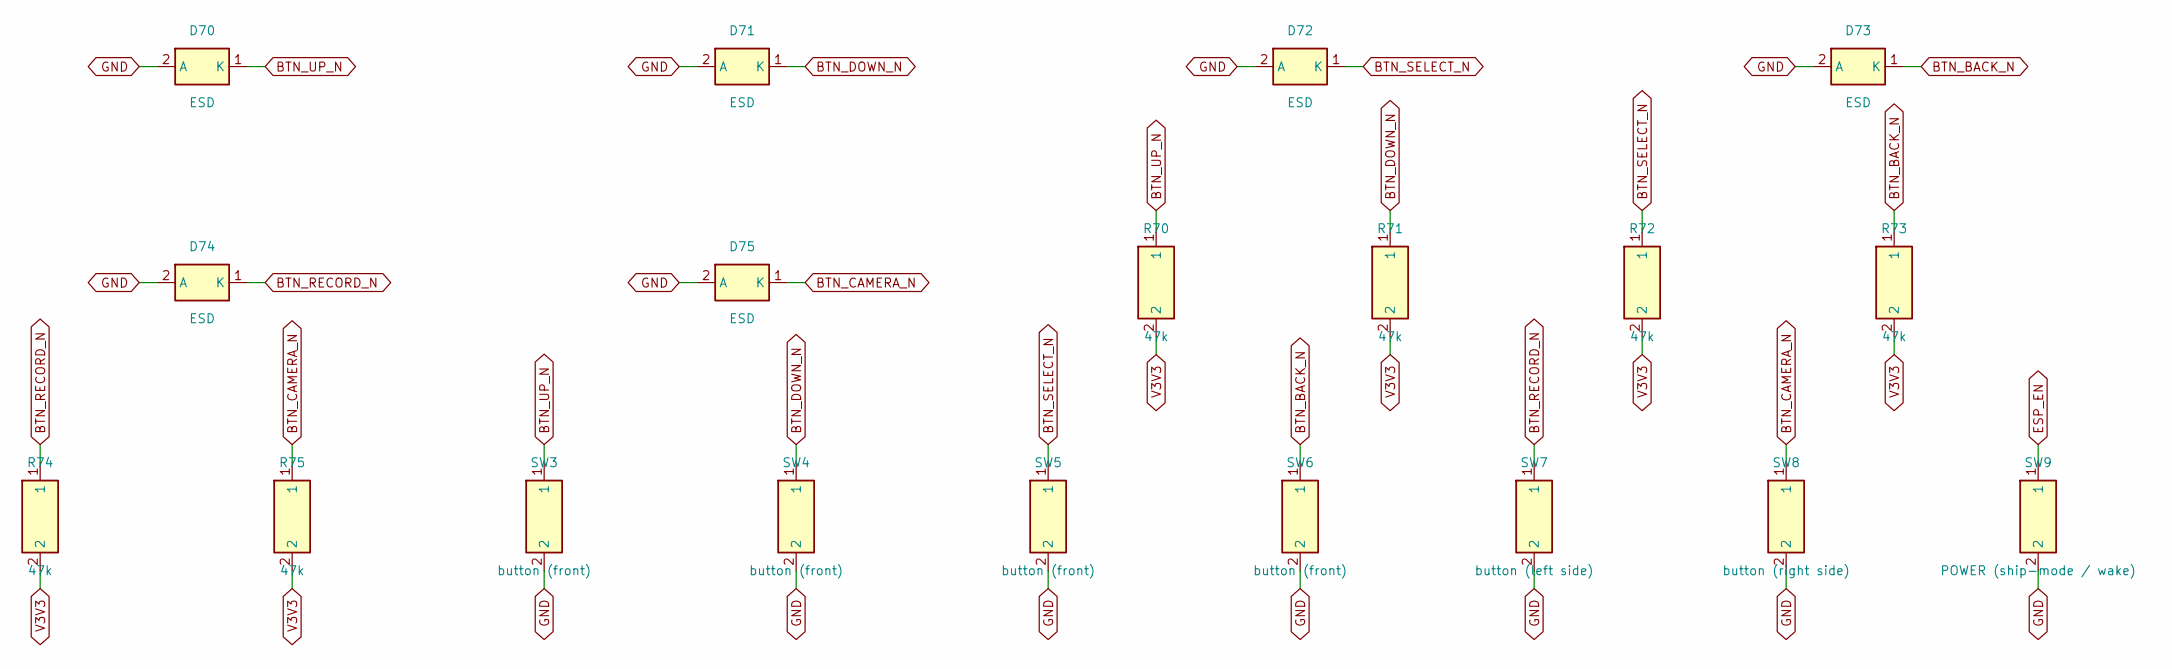
[picture p7: schematic 07_ui.kicad_sch, Nomiq A0 — 07_ui]

Parts:
D70, D71, D72, D73, D74, D75: ESD; D_SOD-882; MPN Nexperia PESD5V0S1BL
R70, R71, R72, R73, R74, R75: 47k; R_0402_1005Metric
SW3, SW4, SW5, SW6: button (front); SW_SPST_PTS810; MPN C&K PTS810 SJM 250 SMTR LFS
SW7: button (left side); SW_SPST_EVQP7A; MPN Panasonic EVQ-P7A01P
SW8: button (right side); SW_SPST_EVQP7A; MPN Panasonic EVQ-P7A01P
SW9: POWER (ship-mode / wake); SW_SPST_EVQP7A; MPN Panasonic EVQ-P7A01P

Connections:
BTN_BACK_N: D73.1 (K), R73.1, SW6.1; also elsewhere on the board
BTN_CAMERA_N: D75.1 (K), R75.1, SW8.1; also elsewhere on the board
BTN_DOWN_N: D71.1 (K), R71.1, SW4.1; also elsewhere on the board
BTN_RECORD_N: D74.1 (K), R74.1, SW7.1; also elsewhere on the board
BTN_SELECT_N: D72.1 (K), R72.1, SW5.1; also elsewhere on the board
BTN_UP_N: D70.1 (K), R70.1, SW3.1; also elsewhere on the board
ESP_EN: SW9.1; also elsewhere on the board
GND: D70.2 (A), D71.2 (A), D72.2 (A), D73.2 (A), D74.2 (A), D75.2 (A), SW3.2, SW4.2, SW5.2, SW6.2, SW7.2, SW8.2, SW9.2; also elsewhere on the board
V3V3: R70.2, R71.2, R72.2, R73.2, R74.2, R75.2; also elsewhere on the board
