anand2532/Nomiq/hardware/kicad/nomiq/nomiq.kicad_pcb

## KiCad design hardware/kicad/nomiq/nomiq.kicad_pcb (continued)

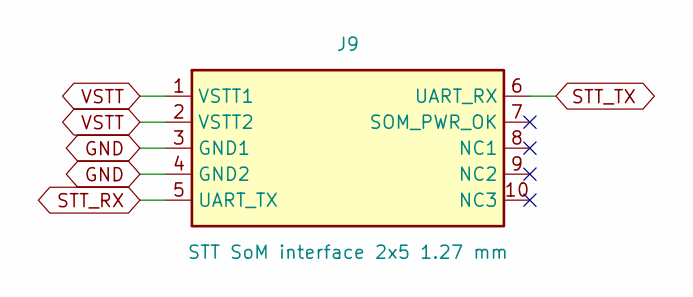
[picture p8: schematic 08_stt.kicad_sch, Nomiq A0 — 08_stt]

Parts:
J9: STT SoM interface 2x5 1.27 mm; PinHeader_2x05_P1.27mm_Vertical_SMD; MPN Samtec FTSH-105-01-L-DV

Connections:
GND: J9.3 (GND1), J9.4 (GND2); also elsewhere on the board
STT_RX: J9.5 (UART_TX); also elsewhere on the board
STT_TX: J9.6 (UART_RX); also elsewhere on the board
VSTT: J9.1 (VSTT1), J9.2 (VSTT2); also elsewhere on the board

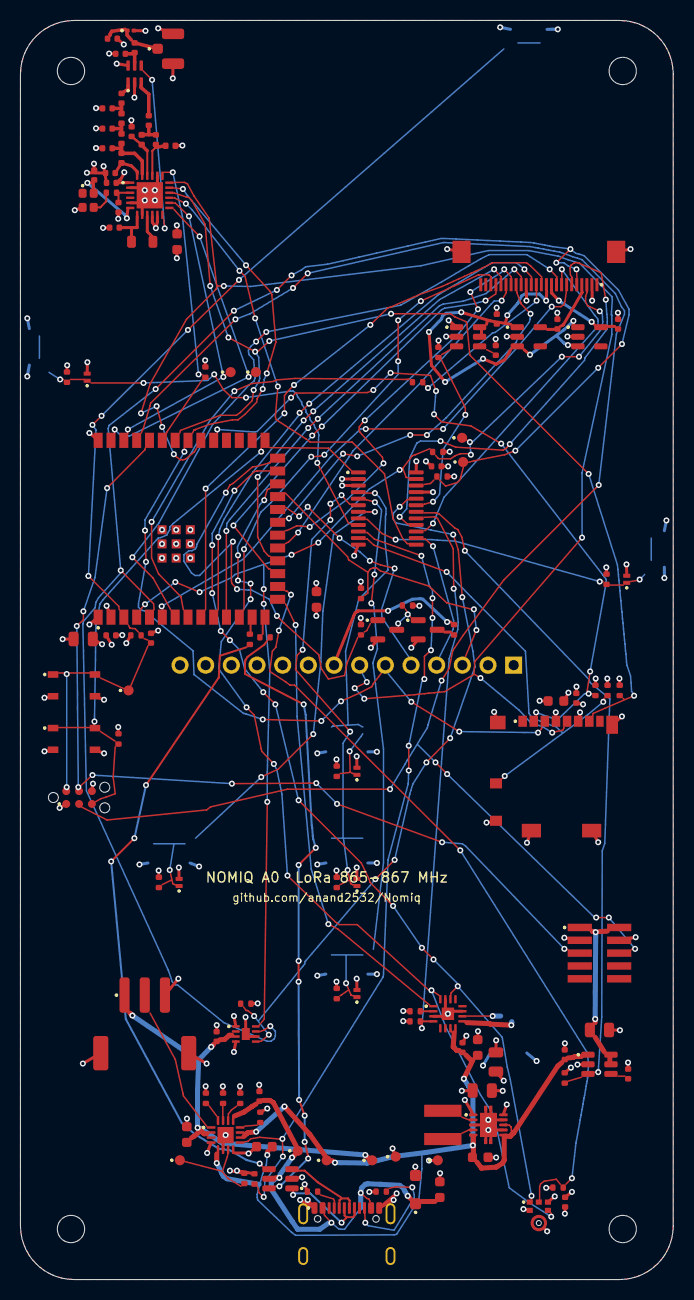
[picture p9: board nomiq.kicad_pcb from above]

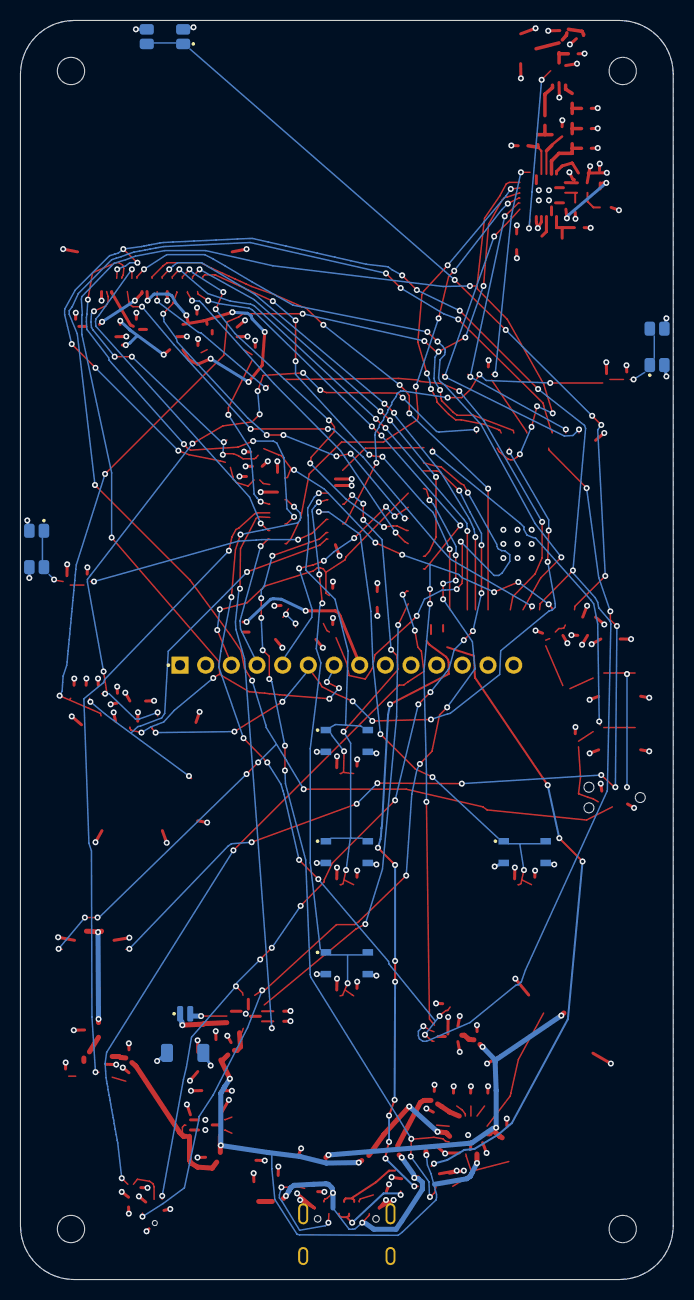
[picture p10: board nomiq.kicad_pcb from below]

Board: 4 copper layers, 64.6 x 124.6 mm, 142 parts (9 on the bottom side), 99 nets.

Other parts of the board:
H1, H2, H3, H4: MountingHole; MountingHole_2.7mm_M2.5
