anand2532/Nomiq/(commit log)

2026-10-23 Project scaffold: docs, firmware skeleton, enclosure, MCP and engineer agents (#2)
    * docs: add README and .gitignore
    Claude-Session: https://claude.ai/code/session_01HafD3UN2tDPG8DjCdm2PVK
    * docs: add traceable requirements, architecture, specs and ADRs
    Claude-Session: https://claude.ai/code/session_01HafD3UN2tDPG8DjCdm2PVK
    * feat(proto): add host-tested Nomiq air protocol core and LoRa airtime tool
    Claude-Session: https://claude.ai/code/session_01HafD3UN2tDPG8DjCdm2PVK
    * feat(fw): add ESP-IDF project skeleton, pin map a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
    [bom-candidates.csv, nomiq.kicad_sch, partitions.csv]
2026-10-23 Link security: AES-128-CCM frames, X25519 pairing, replay protection (#6)
    * feat(proto)!: add 4-byte frame counter to security trailer (max payload 223 B)
    Refs: REQ-RF-009, REQ-RF-011
    * feat(crypto): add AES-128-CCM framing, X25519/HKDF pairing and replay window
    Refs: REQ-RF-009, REQ-RF-011
    * docs(proto): specify security trailer, nonce, pairing and replay rules
    Refs: REQ-RF-009, REQ-RF-011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
2026-10-23 SX1262 radio driver, board bring-up and phase-1 link-test app (#10)
    * feat(radio): add portable SX1262 command driver with datasheet-verified tests
    Refs: REQ-RF-001, REQ-RF-002, REQ-RF-004
    * feat(fw): add board bring-up (devkit/PCB variants) and ESP-IDF radio glue
    Refs: REQ-RF-001, REQ-RF-002, REQ-RF-004
    * feat(fw): add phase-1 link-test app with CSV range logging
    Refs: REQ-RF-001, REQ-RF-002, REQ-RF-004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
2026-10-23 Offline STT benchmark harness and co-processor service (#12)
    * feat(stt): add offline STT benchmark harness with stdlib WER and test prompts
    Refs: REQ-STT-001..006, REQ-SYS-008
    * feat(stt): add ESP32<->co-processor UART framing with resync and shared vectors
    Refs: REQ-STT-001..006, REQ-SYS-008
    * feat(stt): add co-processor STT service for the Linux SoM
    Refs: REQ-STT-001..006, REQ-SYS-008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
2026-10-23 Camera capture with JPEG size control and transfer ETA (#14)
    * feat(camera): add JPEG size fitting and LoRa transfer ETA with tests
    Refs: REQ-CAM-002, REQ-CAM-004, REQ-RF-013, REQ-UI-004
    * feat(camera): add OV2640 capture/preview glue on esp32-camera
    Refs: REQ-CAM-002, REQ-CAM-004, REQ-RF-013, REQ-UI-004
    ---------
    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
2026-10-23 Messenger core: pairing, encrypted link, queue and history (3-device simulation) (#16)
    * fix(proto): send multi-frame TEXT objects via OFFER/DATA, not inline TEXT
    Refs: REQ-SYS-001..007, REQ-RF-009, REQ-STO-003
    * feat(crypto): add incremental SHA-256 (OpenSSL/mbedTLS) with FIPS vector
    Refs: REQ-SYS-001..007, REQ-RF-009, REQ-STO-003
    * refactor(storage): make message store instance-based
    Refs: REQ-SYS-001..007, REQ-RF-009, REQ-STO-003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
2026-10-23 Board A0 connection specification (machine-checked against firmware pin map) (#18)
    * hw: add machine-checked A0 connection spec (128 parts, 97 nets) with generated reports
    Refs: REQ-PCB-001..007
    * build(hw): check connection spec against firmware pin map in host suite
    Refs: REQ-PCB-001..007
    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
    [bom.csv]
2026-10-23 feat(ui): add UI state machine with end-to-end flow tests for modes 1-4 (#20)
    Refs: REQ-UI-001..004, REQ-AUD-003, REQ-AUD-005, REQ-STT-002, REQ-STT-003, REQ-CAM-003
    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
2026-10-23 feat(power): add MAX17048 driver, rail interlocks and battery policy with tests (#24)
    Refs: REQ-PWR-003..005
    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
2026-10-23 Device integration: messenger app, display, buttons, STT link (#26)
    * fix(gitbot): check gh 'workflow' scope before pushing CI files; trim branch slugs
    * feat(ui): add button debouncer and renderer-independent view builder with tests
    Refs: REQ-UI-001..004, REQ-SYS-001, REQ-STT-001
    * feat(app): expose paired contacts for the UI
    Refs: REQ-UI-001..004, REQ-SYS-001, REQ-STT-001
    Clau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
    [buttons.c, buttons.h, display.h, display_lvgl.c, linktest.c]
2026-10-24 Firmware build fixes found by first full ESP-IDF build (#28)
    * fix(fw): enable mbedTLS HKDF/CCM/X25519, fix 256-byte RX buffer truncating to 0, STT text copy
    * ci: build devkit-linktest and pcb-messenger firmware configs, upload binaries, add timeouts
    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
    [messenger.c, radio_esp.c]
2026-10-24 Generated KiCad schematic from netlist with connectivity check and ERC (#30)
    * feat(sch): generate KiCad 8 hierarchical schematic from nomiq_hw.py netlist
    8 sheets, 128 symbols, global-label connectivity verified against the netlist
    (gen_kicad.py --check in make tools). U1/U2 pad maps per datasheet; 32 parts
    flagged with placeholder pads. REQ-HW-001.
    * ci(sch): KiCad 8 ERC + netlist export job (non-blocking), upload report
    C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
    [01_power.kicad_sch, 02_mcu.kicad_sch, 03_radio.kicad_sch, 04_audio.kicad_sch, 05_camera.kicad_sch, 06_display_storage.kicad_sch, 07_ui.kicad_sch, 08_stt.kicad_sch]
2026-10-24 feat(sch): verified pad maps and project footprint library for all 138 parts (#32)
    - fplib.py: 36 footprints from the KiCad library / Espressif library (+ TFT module),
    written to lib/nomiq.pretty and checked (make tools)
    - nomiq_hw.py: per-part datasheet pin->pad maps; gen_kicad checks every pad exists
    and every copper pad is mapped (0 unverified parts)
    - TPS63802 -> TPS63001 (fixed 3.3 V, KiCad DRC land pattern); BQ24074 RILIM/ITERM/TMR
    corrected to datasheet constants; TCXO 1.8 V (E) variant to match DIO3 setting
    - RF blocks expanded into discrete choke, 2-section low-pass, lattice balun, DC blocks
    (PE4259 ports must be DC-free) and DNP pi tuning pads
    - Display: 14-pin ILI9341 modu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
    [01_power.kicad_sch, 02_mcu.kicad_sch, 03_radio.kicad_sch, 04_audio.kicad_sch, 05_camera.kicad_sch, 06_display_storage.kicad_sch, 07_ui.kicad_sch, 08_stt.kicad_sch]
2026-10-24 feat(pcb): complete A0 layout - placement, hand-drawn RF section, routed 4-layer board; enclosure fitted (#34)
    - board.py/placement.py: 64.6x124.6 mm outline, clamp holes, keys, display, USB-C, mic, camera
    and SMA from params.py; electronics on the back-facing F side, UI on the front-facing B side;
    courtyard/keep-out legaliser
    - gen_pcb.py: hand-drawn SX1262 RF chain (PA choke + 2-section low-pass, lattice balun,
    PE4259, u.FL), TCXO, DC-DC loop; GND/3V3 plane fan-out (EP ties, via-in-EP); grid A*
    router (router/astar.c) with rip-up/reroute, local rip-up and power-track widening
    - pcb_check.py: independent clearance/edge/courtyard/connectivity check of the written file:
    0 violations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
    [nomiq.kicad_pcb]
2026-10-24 feat(bom): costed BOM with sourcing and supply risks, JLC BOM + CPL from the PCB (#36)
    gen_bom.py -> hardware/bom/bom-costed.csv and bom-summary.md: board parts $40.66 (qty 1) /
    $27.80 (qty 100); device $83.46 / $46.30 without the STT SoM. Prices from LCSC/element14/Future
    on 2026-10-24 where sourced, estimates otherwise. Risks: BQ24074 out of stock at LCSC,
    TG2016SMN 1.8 V 20-week lead. fab/bom_jlc.csv, fab/cpl_jlc.csv (124 placements).
    REQ-PCB-001
    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
    [bom-costed.csv, bom_jlc.csv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]
2026-10-24 ci(pcb): KiCad zone fill, DRC and fab outputs in CI; test report and A0 bring-up notes (#38)
    - hardware/kicad/tools/fab.py: pcbnew zone fill, kicad-cli DRC (json/report), Gerbers,
    drill + map, position file, STEP, layer PDF, gerber zip; fails on DRC errors/unconnected
    - CI job kicad (kicad/kicad:8.0): ERC, schematic PDF, fab outputs -> artifact nomiq-a0-fab
    - docs/test-report.md (deliverable 12): radio, transfer times, STT accuracy, battery life with
    predicted values, procedures and measurement tables
    - bring-up checklist: A0 test points, debug, charger setpoints, RF tuning, assembly order
    REQ-PCB-007, REQ-RF-001, REQ-STT-001, REQ-PWR-001
    Claude-Session: https://claude.ai/code/session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
